Jvinuelapz/5DoF_Robotic_Arm/5DoF_Robotic_Arm.pdf

5DoF Robotic Arm – Group Project

# CT7158 – Robotic Systems

## 5DoF Robotic Arm – Group Project

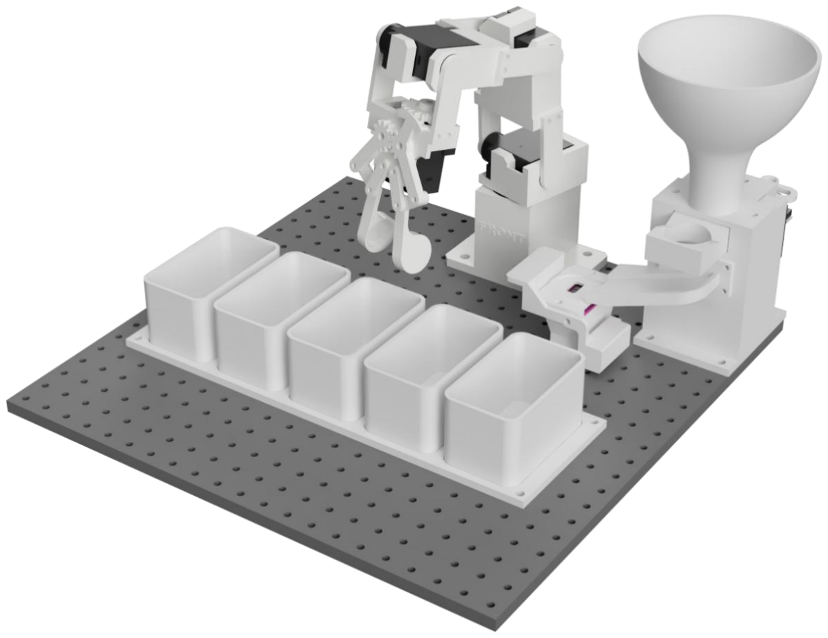
[picture p2: figure]

Authors:
Pawel Toborek (19024794)
Jorge Viñuela (23038621)
Saksham Arora (23022498)
Olayinka Afolabi (23054001)

Supervisors:
Marcio Lacerda
Dion Mariyanayagam
Lynn Crothall

## Table of Contents

## Table of Figures

## List of Tables

## Abstract

This project outlines the design and execution of a 5-degree-of-freedom (5-DoF) robotic arm, including mechanical, electrical, and software components to provide accurate, automated item manipulation. The robotic arm, driven by an ESP32 microcontroller, has servo motors, a color sensor, and an accessible web-based interface for seamless control and operation. The primary functions encompass forward and inverse kinematics, allowing precise movement and placement, alongside a gripper mechanism refined for manipulating tiny items like Skittles.

The arm's capacity to categorize things by color was achieved using sophisticated kinematic algorithms, accurate motion control, and instantaneous data processing. Safety methods were instituted to improve dependability, encompassing joint angle restrictions, motion smoothing, and effective error management. The idea utilized economic materials and 3D-printed elements, guaranteeing accessibility and affordability.

The results indicate the arm's efficacy as a multifunctional platform for educational applications, research, and minor industrial operations. This study highlights the promise of affordable, high-performance robotic systems, establishing a basis for future progress in robotics and automation.

## I. Introduction

## Objective

The objective of this project is to design and develop a 5-degree-of-freedom robotic arm using an ESP32 microcontroller. This project aims to:

1. Build and optimize the robotic arm's structure, including a high-precision gripper.
2. Implement kinematic algorithms to enable accurate control and movement.
3. Develop a user-friendly, web-based interface for intuitive control of the robotic arm.
4. Integrate wireless connectivity to allow remote access and operation.

By achieving these objectives, the project seeks to create a versatile robotic arm suitable for tasks requiring precision and adaptability, while providing a learning platform for robotics and control systems.

## Problem Statement

In various fields such as manufacturing, research, and education, there is a growing need for adaptable and precise robotic systems that can perform complex tasks with minimal human intervention. Traditional robotic arms often lack affordable control solutions with advanced features like wireless connectivity, customizable kinematics, and user-friendly interfaces, which limits their accessibility and usability in smaller-scale or educational contexts [1,2].

This project addresses these issues by developing a low-cost, 5-degree-of-freedom robotic arm that uses an ESP32 microcontroller. The arm will be controlled via an intuitive web-based interface, allowing easy, remote operation and control. Additionally, by optimizing the gripper and implementing kinematics, this project aims to enhance the robotic arm’s precision, making it suitable for applications requiring accurate manipulation and positioning. The project therefore aims to bridge the gap between functionality, affordability, and accessibility in robotic arm systems.

## Relevance of the project

This project holds significant relevance as it combines multiple disciplines—mechanical design, electronics, programming, and kinematics—to create a versatile robotic arm [7]. By using a 5-degree-of-freedom structure, the arm can achieve a high level of manoeuvrability, which is essential for real-world applications like precise object manipulation and sorting. Leveraging the ESP32 microcontroller offers a cost-effective, powerful platform with built-in Wi-Fi, enabling remote control through a user-friendly web interface. This connectivity expands potential uses, from industrial automation to remote education and research applications [8,9,10].

Furthermore, optimizing the gripper design and implementing kinematic algorithms are crucial for achieving accurate and responsive movement. These capabilities enhance the arm’s ability to perform tasks with precision, which is valuable for robotics research and provides students with hands-on experience in solving complex, real-world engineering challenges. This project thus not only serves as an educational tool but also lays the foundation for advancements in robotic control systems and applications.

## Background

Robotic Arm

A robotic arm is a programmable mechanical device that mimics the motion and functionality of a human arm. It typically consists of multiple segments, or links, connected by joints that allow for various degrees of freedom (DoF). Robotic arms are commonly used in industries such as manufacturing, medical technology, and research, where precise, repeatable movements are required. In this project, we aim to design a 5-degree-of-freedom robotic arm capable of performing precise tasks such as sorting and object manipulation. Developing this robotic arm requires careful planning of its kinematic structure, control systems, and end-effector (or gripper) design to ensure both accuracy and reliability [1,3,4,5].

Servo MG90S

The MG90S is a compact, high-torque servo motor commonly used in robotics applications due to its affordability, lightweight design, and performance [13]. It features a metal gear train that ensures durability and precision, making it ideal for applications where high torque and precision control are necessary. Each joint in the robotic arm is driven by an MG90S servo motor, which allows for fine-grained control of the arm’s movement across its various degrees of freedom. These servo motors are critical for achieving the precision required for tasks such as sorting and manipulating objects [6,7,8].

ESP32

The ESP32 is a powerful microcontroller with integrated Wi-Fi and Bluetooth capabilities, making it a popular choice for IoT and robotics applications [12]. Its high processing power, real-time control capabilities, and connectivity options make it ideal for controlling robotic systems like the 5-DoF robotic arm in this project. The ESP32 allows for precise motor control, easy integration of sensors, and wireless communication. This wireless capability is particularly valuable for developing a web-based interface, allowing users to control the robotic arm remotely, enhancing usability and accessibility [9,4,3].

Inverse Kinematics

Inverse kinematics (IK) is a mathematical approach used to calculate the required joint angles of a robotic arm to position its end effector at a specific location and orientation in space. In contrast to forward kinematics, which determines the position of the end effector based on known joint angles, inverse kinematics works backward, starting from the desired endpoint to determine the necessary joint parameters. IK is crucial for applications requiring precision, as it enables the robotic arm to perform complex, accurate movements, allowing it to reach specific points in its workspace. Implementing inverse kinematics in this project will provide the robotic arm with the ability to accurately move and position its gripper, enhancing its usefulness for tasks that require exact positioning, such as sorting or picking objects [1,6,8,5].

## II. Hardware design

The hardware design of the robotic arm incorporates a variety of mechanical and electrical components, ensuring the functionality, stability, and precision required for its operation. This section details the components used in the design, including a Bill of Materials (BOM) and a breakdown of the 3D-printed parts.

## Bill of Materials (BOM)

The table below outlines the components required to assemble the arm, which includes electronic components, servo motors, and various fasteners and bearings. The BOM ensures that all necessary components are accounted for and provides flexibility in sourcing, as it includes detailed specifications for each item.

No | P/N | Link | Price | Items
1 | Torx Screw Set | https://amzn.eu/d/iVCb0gH | £7.99 | Set 760 Pieces
2 | 6x10x3mm Bearings | https://amzn.eu/d/bLbZnPb | £7.99 | 10
3 | 7x22x8mm Bearing | https://amzn.eu/d/cW2G3Cp | £7.09 | 8
4 | TCS34725 | https://amzn.eu/d/2pwwxkY | £4.99 | 1
5 | Servo MG90S | Provided | - | 6
6 | ESP32 Devkit V1 | Provided | - | 1
7 | PCA9685 | Provided | - | 1
8 | SD Card Reader | Provided | - | 1
Table 1. Bill Of Materials

## 3D-Printed parts:

The arm relies heavily on custom-designed 3D-printed parts for its structural integrity. These parts are essential for creating the joints, segments, and gripper mechanisms that facilitate movement and manipulation tasks. Important to remark that the whole robot was redesigned, not only the gripper. The following table provides a detailed breakdown of the required 3D-printed parts.

No | Name | Count
1 | Base | 1
2 | Segment1 Base | 1
3 | Motor Shaft Swing | 3
4 | Bearing Swing | 3
5 | Segment2 Base | 2
6 | Gripper Base | 1
7 | Gripper Main Gear | 1
8 | Gripper Left Gear Arm | 1
9 | Gripper Right Gear Arm | 1
10 | Gripper Left Link | 1
11 | Gripper Right Link | 1
12 | Gripper Left Clamp | 1
13 | Gripper Right Clamp | 1
Table 2. 3D-Printed Parts

Figure 1 shows the 3D-printed components required for the assembly of the robotic arm, each part is positioned for optimal printing, and the preview highlights details such as supports, infill, and walls. The visible parts include bases, joint connectors, motor holders, and the gripper mechanism, all essential for the arm's structural integrity and functionality. The slicing summary indicates a total filament usage of approximately 58.45 grams and an estimated print time of 2 hours.

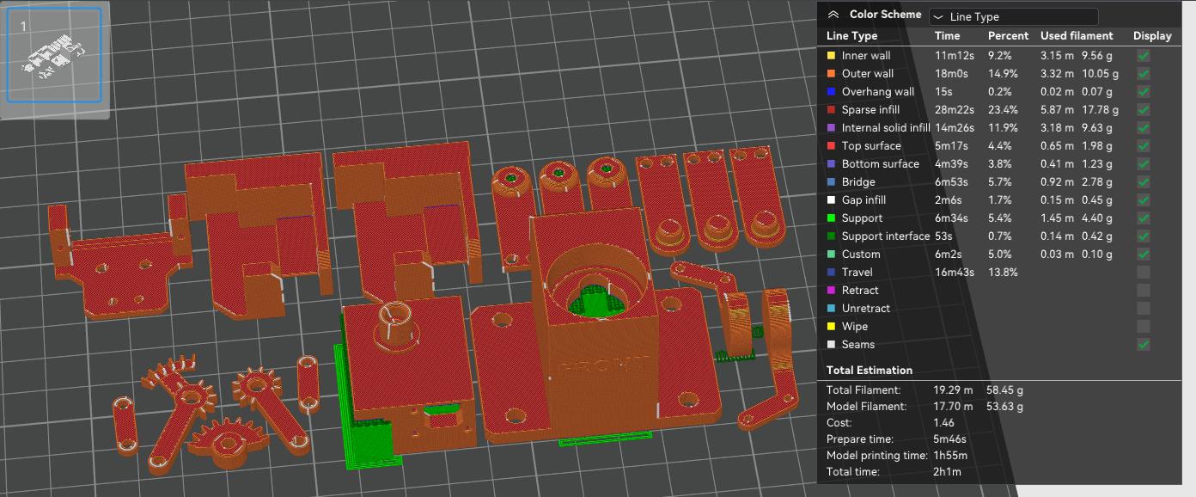
[picture p3: figure]

Figure 1. 3D-Printed Parts Layout and Printing Details

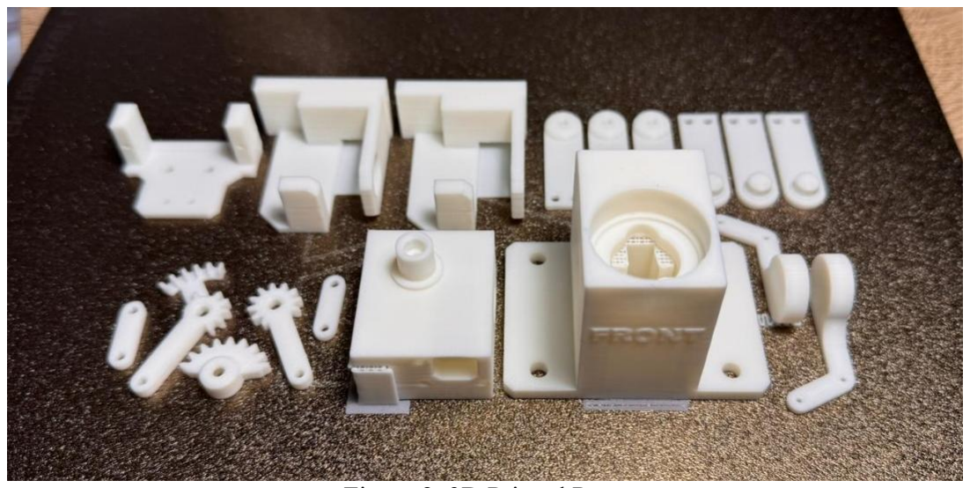
[picture p4: figure]

Figure 2. 3D Printed Parts

## Assembly and Integration

Finally, the integration joins electronic components and 3D-printed parts into a cohesive system. The servos (MG90S) are controlled via the ESP32 microcontroller, which communicates with the PCA9685 servo driver [15]. The structural components are assembled using the screws, spacers, and bearings listed in the BOM, ensuring stability and minimizing wear during operation. The following figure illustrates the complete assembly of all components that form the arm and provides two perspectives of the arm as modelled in Autodesk Fusion 360 [11], showcasing the structural design and arrangement of parts in a 3D environment.

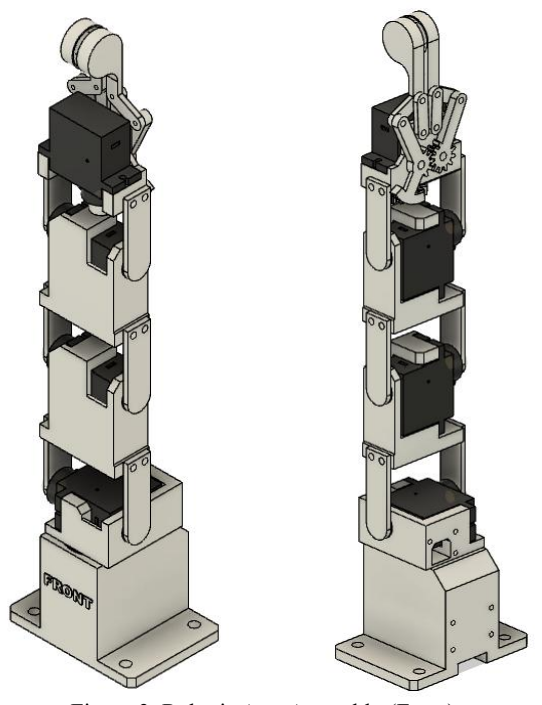
[picture p5: figure]

Figure 3. Robotic Arm Assembly (Front)

Figure 4. Robotic Arm Assembly (Back)

## Wiring Diagram

This section illustrates the electrical connections and integration of the core components, by providing a detailed overview of how the ESP32 microcontroller interfaces with the peripheral modules, including the PCA9685 PWM driver, the TCS34725 colour sensor [14], and the SD card module. Proper wiring ensures efficient communication between components, power delivery, and synchronization, which are critical for the robotic arm's functionality and performance.

Firstly, the ESP32 Devkit V1 is the central microcontroller in the system and is powered by both 5V and 3.3V supplies. The connections include:
- SDA and SCL pins (I2C communication): connected to peripherals such as the PCA9685 PWM driver and the TCS34725 colour sensor.
- MOSI, MISO, and SCK pins (SPI communication): primarily interfacing with the SD card reader module.
- SD_EN pin: used to enable or control the SD card module.

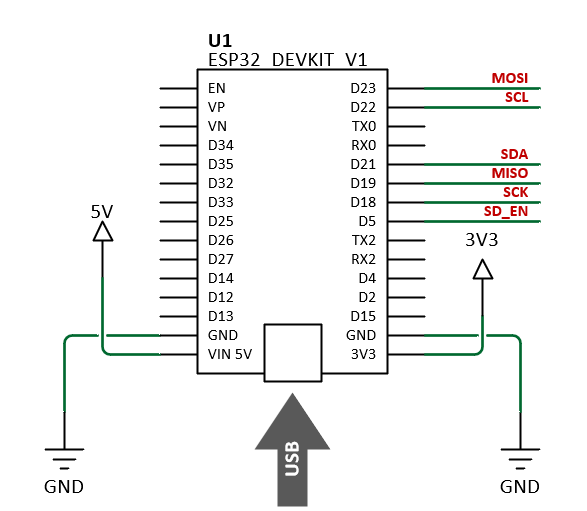
[picture p6: figure]

Figure 5. ESP32 wiring diagram

The PCA9685 servo driver is connected to the ESP32 via the I2C, operates at 3.3V logic levels and drives up to 16 channels of servos.
- Channels CH0 to CH5: used for controlling six servo motors (SERVO_0 to SERVO_5).
- V+ pin: supplies power to the servos, which is independent of the PCA9685’s operating voltage and is provided through an external 5V supply.

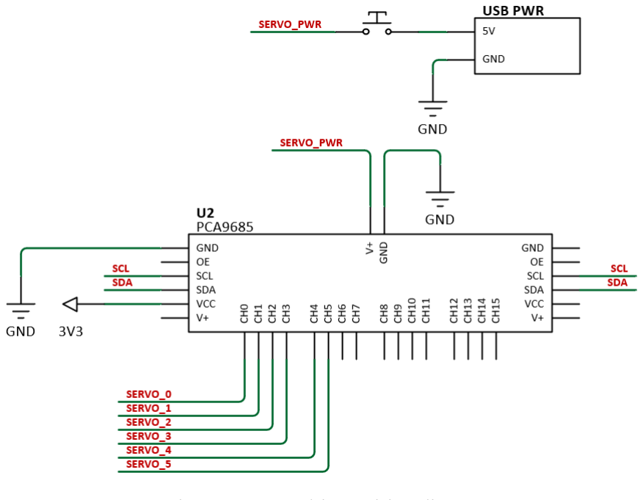
[picture p7: figure]

Figure 6. Servo driver wiring diagram

The TCS34725 colour sensor is also connected to the ESP32 using the I2C interface and operates at 3.3V, with:
- SDA and SCL lines linked to the ESP32 for data communication.
- VIN and GND connected to power and ground, ensuring proper operation of the sensor.

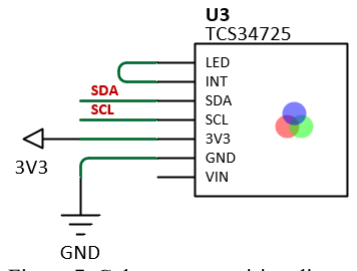
[picture p8: figure]

Figure 7. Colour sensor wiring diagram

Finally, the SD Card module interfaces with the ESP32 using SPI communication:
- MOSI, MISO, SCK, and SD_EN pins: connected to their respective pins on the ESP32.
- VIN and GND connected to power and ground, ensuring proper operation of the sensor, same as in the previous component.

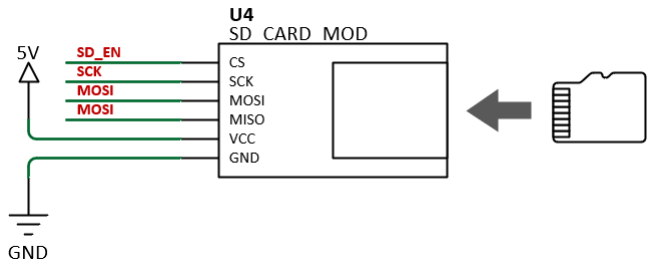
[picture p9: figure]

Figure 8. SD Card wiring diagram

## III. Software Design

## Robotic Arm

This section describes the arm’s different functionalities, showcasing its ability to perform precise and complex movements through advanced algorithms and robust control mechanisms. It is equipped with servo motor control for seamless and accurate joint movements, inverse kinematics for calculating joint angles to achieve specific end-effector positions, and G-code support for programmable, task-specific actions. Additionally, the integration of a colour sensor enables dynamic object detection and sorting, making the arm versatile for a range of applications.

Each functionality is designed to operate cohesively, providing a reliable and efficient system that can adapt to real-world tasks requiring precision and automation. Below, detailed explanations and code snippets highlight the implementation of these functionalities, illustrating how they contribute to the arm’s overall performance.

Arm Definition

The robotic arm is implicitly defined through the combination of servo motor channels managed by the Adafruit_PWMServoDriver and the control logic that governs their movements. The following elements together define the arm:

1. Servo Channels: The arm's joints are represented by up to 16 servo channels on the PCA9685 PWM driver, as instantiated here:

Figure 9. Servo Channels Definition

2. Arm’s links: The arm's structure and movement are governed by inverse kinematics algorithms, as seen in the solveIK3D and solveIK functions. These functions define the geometry of the arm using linkLengths and calculate the required joint angles:

Figure 10. Links Definition

3. Servo Positions: The current and goal positions of the servos are stored in arrays:

Figure 11. Servo Positions Definition

Servo and Speed Control

The robotic arm uses PWM signals to control the angles of the 6 servo motors. The servo positions are mapped from angles in degrees (0–180) to PWM pulse lengths, where each servo is individually addressed, allowing precise control of joint angles.

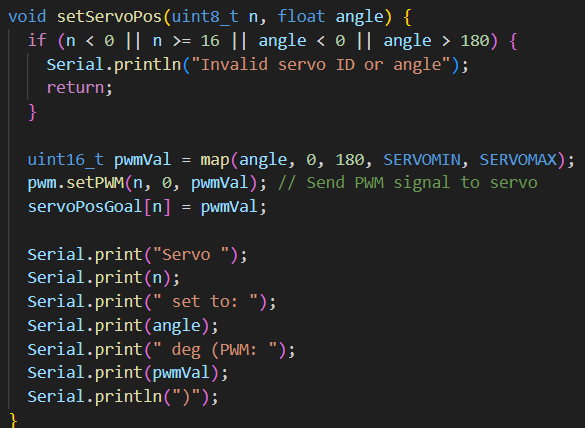
[picture p10: figure]

Figure 12. SetServoPos function

The “setServoPos” function controls the position of a servo motor by converting a given angle into the corresponding PWM signal, which is then sent to the servo using the Adafruit PCA9685 driver. It validates the input to ensure the servo ID and angle are within acceptable ranges and then uses the map function to translate the angle into a PWM pulse length, ensuring the servo moves to the desired position. The resulting PWM value is stored in the “servoPosGoal” array for tracking, and detailed logs are printed for debugging.

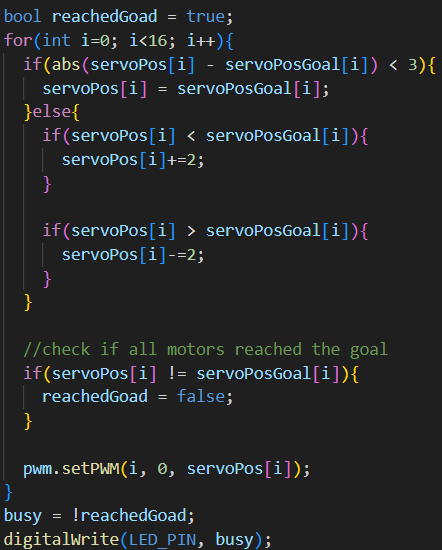
[picture p11: figure]

Figure 13. Smooth servo movement implementation

Once the desired servo position has been obtained, the loop function ensures a smooth servo movement by gradually adjusting each servo's position toward its target, shown in figure 11. If the difference is small, the servo is directly set to the target; otherwise, its position is incrementally increased or decreased to avoid abrupt movements. The program tracks whether all servos have reached their targets using the “reachedGoad” flag, updating the busy state, accordingly, reflected on LED_PIN, which serves as a visual indicator of whether the servos are still in motion or idle.

## Web interface

The website interface was written using HTML and JavaScript. To get the 3D visualization p5js library was used, as it provides easy graphical interface capable of 3D rendering using WEBGL. The website files are served by the ESP32 server inside the SD card with all necessary files. The 3D models are “.stl” files loaded by the JavaScript code.

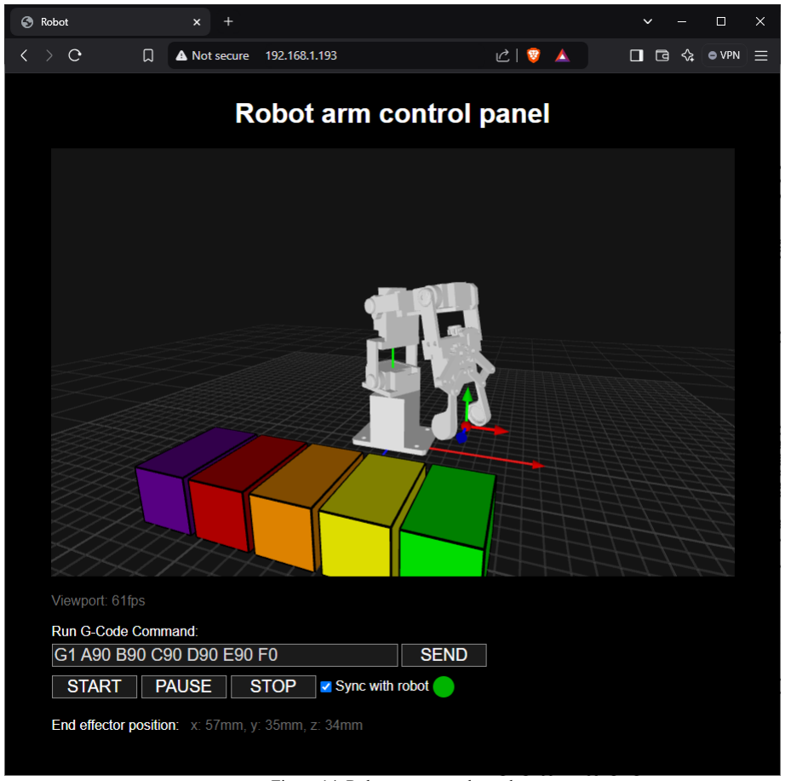
[picture p12: figure]

Figure 14. Robot arm control panel

The web interface includes a text field that allows the user to input G-Code commands to control the robotic arm. Several G-Code commands are supported, including G0, which accepts XYZ coordinates and utilizes inverse kinematics to move the arm to the specified position. Additionally, G1 enables direct control of the motor angles for each joint, offering precise adjustments for the arm's segments. This command also facilitates the operation of other servo channels, making it possible to integrate and manage additional hardware seamlessly.

## Colour Sensor

The integration of the colour sensor adds a vital functionality to the robotic arm, enabling it to detect and classify objects (Skittles) based on their colour. The sensor (TCS34725) reads the red, green, and blue (RGB) components of an object and matches them to predefined categories stored in the “colorList” array. Each entry in the array represents the average RGB values for a specific colour, such as red, green, yellow, or purple.

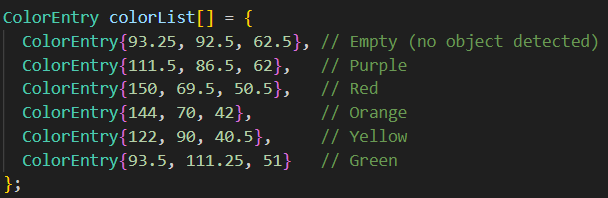
[picture p13: figure]

Figure 15. Colour List Definition

Each colour is represented by its red, green, and blue intensities, allowing the program to match sensor readings to these predefined values. Next, the program calculates the Euclidean distance between the sensor's current RGB readings (r, g, b) and each predefined colour in the list. The colour with the smallest distance is selected as the detected colour, provided the distance is within a defined threshold. This process is described in the following figure.

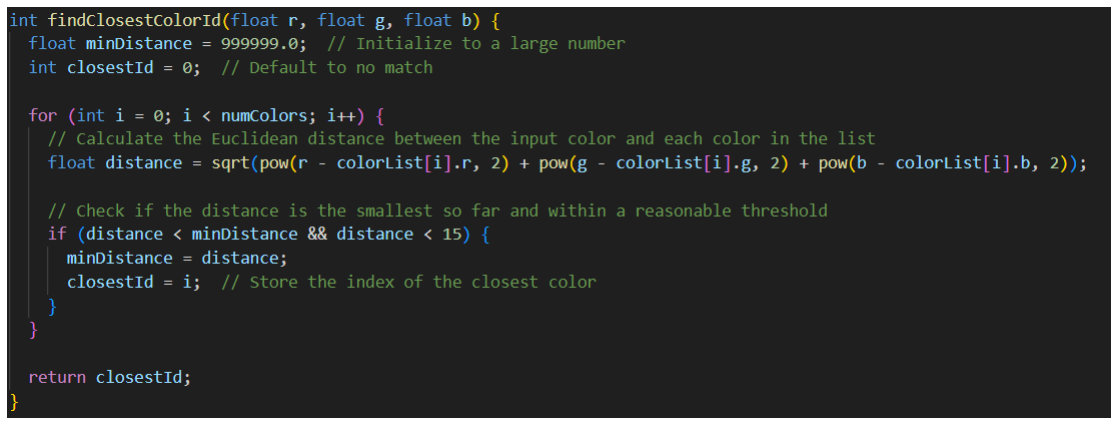
[picture p14: figure]

Figure 16. FindClosestColorId Function

These functions allow the robotic arm to continuously detect colours in real time, ensuring precise and accurate classification for the objects used in this project.

## IV. Inverse kinematics and Safety Mechanism

## Introduction to Inverse Kinematics

Inverse Kinematics (IK) is a fundamental concept in robotic control, enabling the calculation of joint angles to position an end-effector at a specified Cartesian coordinate. IK plays a critical role in improving the functionality of robotic arms by allowing precise, repeatable motions, essential for tasks like assembly, manipulation, and navigation in constrained environments. This section discusses the mathematical underpinnings of IK, the integration of safety mechanisms, and challenges and solutions in implementing these techniques [1][4].

## Mathematical interpretation

The implementation used for the robot described in this report first converts 3D position to 2D position and then solves the IK in 2D space.

The 3D to 2D conversion is done as follows:

baseRot = atan2(Tz

, Tx)
dist = √Tx
2 + Tz

2

dist is the X coordinate in 2D space
Y coordinate is the same as in 3D space (Ty) baseRot is used as the angle for base servo motor.

Forward kinematics:
is the process of calculating the position and orientation of the end-effector based on the joint parameters (such as angles or displacements) of the links in a kinematic chain.

In 2D space this can be done using trigonometric equations:

x = cos(θ1

) ∗ len1 + cos(θ1 + θ2

) ∗ len2 + cos(θ1 + θ2 + θ3

) ∗ len3
y = sin(θ1

) ∗ len1 + sin(θ1 + θ2

) ∗ len2 + sin(θ1 + θ2 + θ3

) ∗ len3

If necessary, the x and y coordinates can be translated by the robot origin position. The forward kinematics algorithm will use forrard kinematics to solve IK with CCD.

2D Inverse Kinematics (CCD):
The Cyclic Coordinate Descent (CCD) algorithm iteratively adjusts each joint of the kinematic chain, starting from the end effector (the last joint) and working backward toward the root joint.

At each iteration, the algorithm modifies one joint's angle to minimize the distance between the end effector and the target.

First, the algorithm checks the distance between the target and current position of the robot’s end-effector. If it is less than the threshold the algorithm returns current motor positions. If the target is not reached, the algorithm calculates the angle to the joint by determining the vector between the joint and the end-effector, as well as the vector between the joint and the target. It then computes the angular difference between these vectors and adjusts the joint's angle accordingly to reduce the distance to the target. This process is repeated iteratively for each joint in the chain until either the target is reached within the specified threshold, or the algorithm reaches its iteration limit.

## Code Implementation

Forward Kinematics

The “calculatePosition” function computes the Cartesian position of a specified point in the robotic arm, such as an intermediate joint or the end-effector. It uses the angles of the joints and the lengths of the links in the arm to iteratively calculate the cumulative position of the arm in 2D space. This function is essential for determining the spatial coordinates of any point along the arm, which is crucial for both visualizing the arm's configuration and performing inverse kinematics calculations.

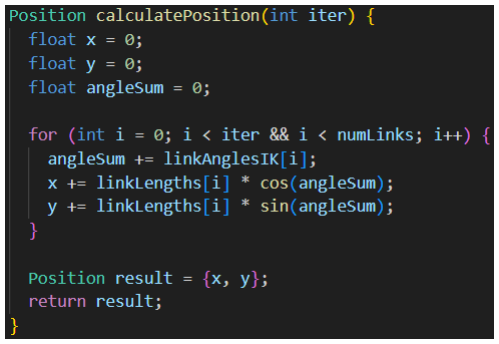
[picture p15: figure]

Figure 17. CalculatePosition function

It iterates through the arm's links up to the specified joint (iter), summing joint angles to determine the arm's cumulative orientation. For each link, it calculates the horizontal and vertical contributions using trigonometric functions scaled by the link lengths, adding these to the running totals. Once all links are processed, the function returns a Position struct with the calculated x and y coordinates, enabling the determination of any joint or end-effector position for motion planning and control. This function is essential for inverse kinematics as it calculates the current position of the end-effector or joints, providing the necessary feedback to iteratively adjust angles and minimize the distance to a target.

Inverse Kinematics

This section explores the implementation of inverse kinematics (IK) for controlling the robotic arm, enabling it to precisely position its end-effector at any target within its workspace. The IK process involves breaking down complex 3D movements into individual joint angles using geometric calculations and algorithms like Cyclic Coordinate Descent (CCD). To achieve this, there are two main functions that we have implemented: solveIK and solveIK3D.

### 1. SolveIK

This function computes the inverse kinematics for a 2D planar arm using the Cyclic Coordinate Descent (CCD) algorithm. Starting from the end-effector, it iteratively adjusts the angles of each joint to minimize the distance between the end-effector and the target position. Then, the CCD algorithm calculates the angle between two vectors: one from the joint to the end-effector and another from the joint to the target and uses this angle to modify the joint’s position and bring the end-effector closer to the target.

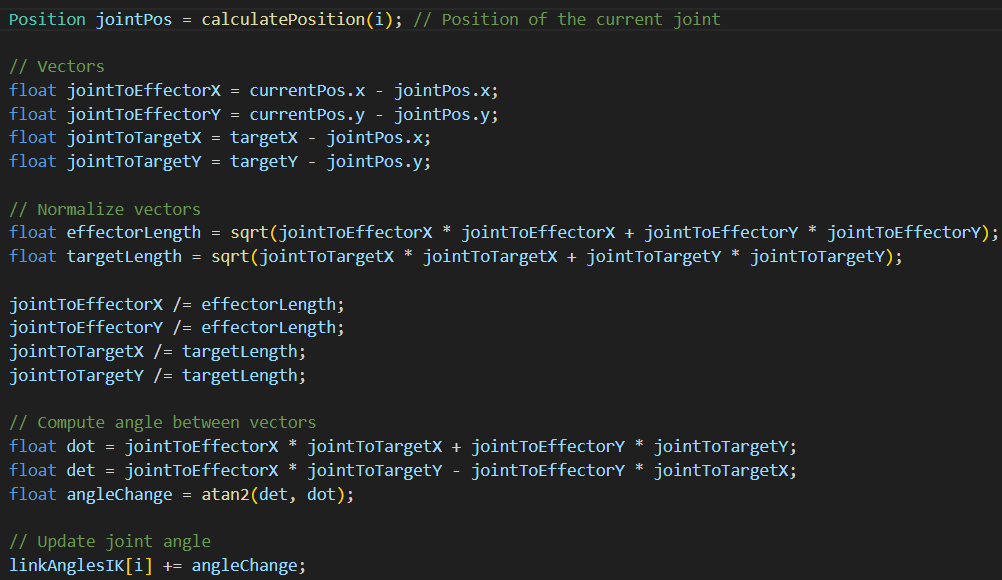
[picture p16: figure]

Figure 18. SolveIK3D function

The process is repeated for each joint in the chain, working backward from the end-effector to the base and continues iterating until the target is reached within a specified tolerance or the iteration limit is exceeded. This function ensures that the arm's joints are positioned correctly to achieve the desired target while respecting physical constraints, such as joint angle limits.

### 2. SolveIK3D

This next function handles the high-level logic for solving inverse kinematics in a 3D space. Firstly, it adjusts the y coordinate to account for the arm's geometry and calculates the base rotation angle to align the arm's base with the target position in the XZ plane, which reduces the target to a planar distance in this plane, effectively converting the 3D problem into a

2D problem. Secondly, the solveIK function previously explained, is called to compute the joint angles in the 2D plane, which are crucial for positioning the end-effector.

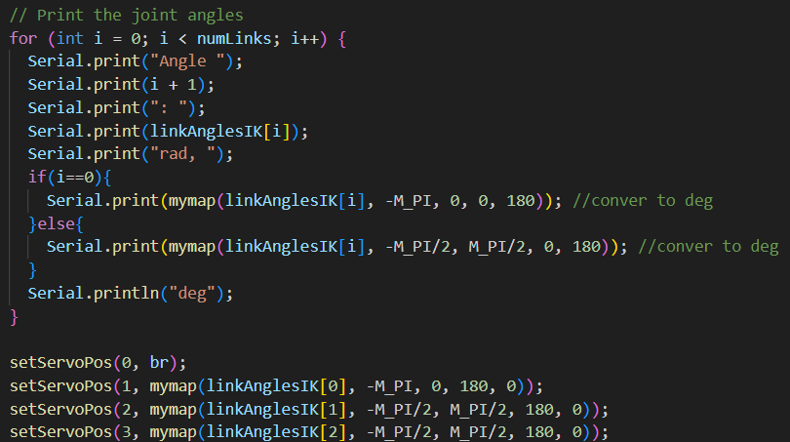
[picture p17: figure]

Figure 19. SolveIK function

After solving the 2D IK, the function maps the calculated base rotation and joint angles to servo-compatible values using the “mymap” function, which scales the input angles from their original range to the range required by the servos. Finally, it sets the positions of the base and joint servos using setServoPos. This function serves as the primary interface for positioning the arm in 3D space.

G-Code Integration

The control system incorporates a G-code interface, enabling the user to program and execute precise sequences of movements and actions through G-code commands, which provide a standardized way to communicate instructions to the arm, offering flexibility and ease of use for complex tasks. To achieve this, the “runGCodeCommand” function was implemented, which parses each command to determine its type (G0 or G1) and extracts the parameters needed for execution. Two G-code commands were added to the project: G0 for inverse kinematics, and G1 for forward kinematics.

### 1. G0 Command

It is used to move the arm to a specific position in the space by specifying XYZ coordinates. Upon receiving a G0 command, the system invokes the solveIK3D function, which calculates the required joint angles and allows the arm to seamlessly reach the target position while respecting its physical constraints. Figure 15 shows the implementation of the “handleG0Command” function.

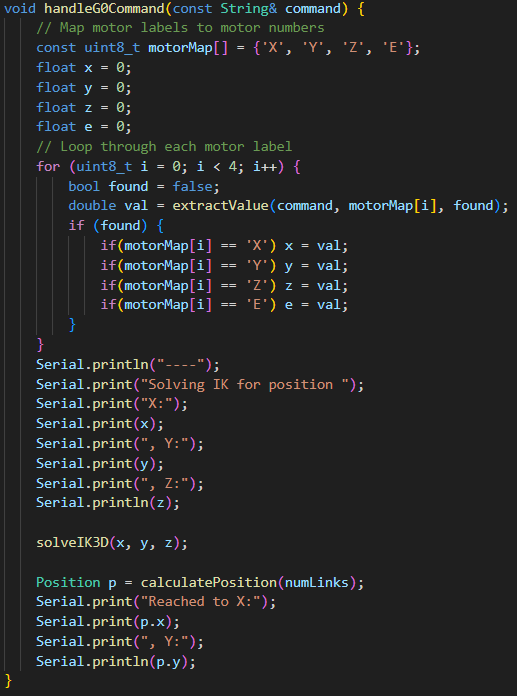
[picture p18: figure]

Figure 20. HandleG0Command function

- Extracting Target Coordinates: It parses the G-code command to extract X, Y, Z, and E values, representing the target 3D position and an optional parameter.
- Solving Inverse Kinematics: It passes the extracted x, y, and z coordinates to the solveIK3D function, which computes the joint angles necessary to move the arm’s end-effector to the specified target position.
- Debugging and Verification: The function prints the extracted coordinates and the arm's final calculated position to ensure the movement is executed as expected.

### 2. G1 Command

It enables direct control of the arm by specifying individual motor angles for each joint (forward kinematics). This command was particularly useful for fine-tuning the movements and creating the loop of sorting the skittles.

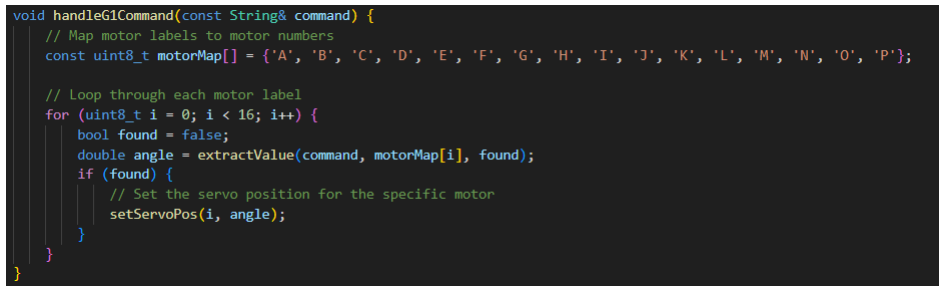
[picture p19: figure]

Figure 21. HandleG1Command function

- Extracting Motor Angles: The function iterates through the motorMap and retrieves the specified angle from the command string. If a valid angle is found, the found flag is set to true, and the angle is stored.
- Setting Servo Positions: If a valid angle is extracted for a motor, the setServoPos function is called, which updates the corresponding servo to the specified position, allowing precise control of each motor based on the command input.

## Viable Safety Features

There are a series of safety features that were implemented throughout the code that contributed to making a secured execution.

### 1. Joint Angle Limits

During the inverse kinematics (IK) calculation in “solveIK” function (Figure 15), the joint angles are clamped to specified limits. This ensures that the arm does not exceed its physical constraints, preventing damage to the servos or structural components.

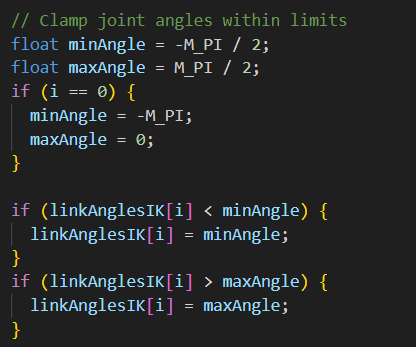
[picture p20: figure]

Figure 22. Angle Limitations Implementation

### 2. IK Iteration Limits

In the solveIK function (Figure 15), the algorithm limits the number of iterations to 100, thus if the solution does not converge within this limit, the process is aborted, and an error message is printed. This prevents the system from entering an infinite loop or performing unnecessary calculations.

Figure 23. IK Iteration Limit Message

### 3. Servo Validation

The setServoPos function (Figure 10) includes checks to ensure that the servo ID and the angle fall within valid ranges. This prevents invalid commands from being sent to the servos, protecting them from operating outside their physical or electrical limits.

### 4. Smooth Motion Control:

The incremental movement logic in the loop function ensures that servos move gradually toward their target positions, which avoids abrupt movements that could strain or damage the arm’s structure or servos. This process was explained in detail in Servo and Speed Control Section.

### 5. Error Detection

The code includes error-handling mechanisms to detect missing or improperly connected components, such as the SD card or colour sensor. If an issue is detected, the program halts or skips operations to prevent further errors.

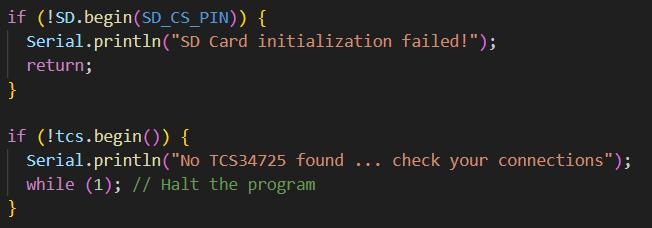
[picture p21: figure]

Figure 24. Disconnected Components Error Messages

## Challenges Faced

Hardware
When designing the hardware, it was noted that the SD card module used required 5V supply. The solution was to connect the VCC to VIN pin on the ESP32 which has direct connection to the USB 5V.

Firmware

Inverse Kinematics posed many challenges due to the limitations of visualising the robot. Also, compilation and upload time is considerable when performing iterative testing and debugging. To ease the development, cycle the IK algorithm was first tested in JS before it was ported to the C++. The algorithm used to solve the IK was finetuned to respect the limitations of the robot, but it has some drawbacks, there are positions that it fails to reach even when it is possible.

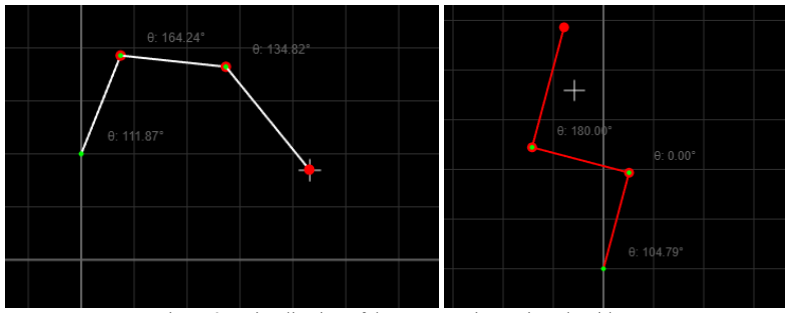
[picture p22: figure]

Figure 25. Visualization of the Inverse Kinematics Algorithm

Implementing Inverse Kinematics in 3D space can get very complex. But the robotic arm described in this report can be treated as 2D robot with rotating base. This is helpful when implementing IK. From the 3D coordinates we can derive the rotation where the robot should face, then we can solve the 2D inverse kinematics, and apply resulted rotations to the robot.

Web Interface

The biggest issue that was faced when developing the web interface was the ESP32 limitation to handle one network request at the same time. Modern servers are fast and capable of serving many clients and requests at the same time. When developing web interface with multiple files for the ESP32 it was crucial to make each request once the previous was finished. Additionally, it was common for the request to fail due to network related issues or since the ESP was not fast enough. To solve this problem, the web interface retries 3 times when the request fails. It also makes sure that there is only one request executed at any given time.

Inverse Kinematics Angles Mapping

During the implementation of the inverse kinematics in the “solveIK3D” function, we encountered a significant challenge with the default map function provided by the Arduino framework. This function is designed to scale input values from one range to another, but it operates exclusively with integers, which posed a problem because the calculations in the inverse kinematics process involve floating-point values, particularly when converting angles in radians to servo-compatible ranges.

To overcome this limitation, we implemented a custom “mymap” function, that unlike the default map function, it supports floating-point arithmetic, ensuring that the scaling of values is precise and free from rounding errors.

Figure 26. Mymap Function

The function was specifically tailored to handle the conversion of joint angles from their calculated ranges to the servo's operational range of [0, 180].

## V. Gripper Improvement

This section focuses on the enhancements made to the robotic arm's gripper, a critical component responsible for handling and manipulating objects. The primary objective of the gripper was to effectively grab and hold Skittles, which guided the development of each design. To explore diverse approaches and optimize performance, each team member designed a unique gripper tailored to this goal. By fostering individual creativity, the team aimed to identify innovative solutions and integrate the most effective features into the final design.

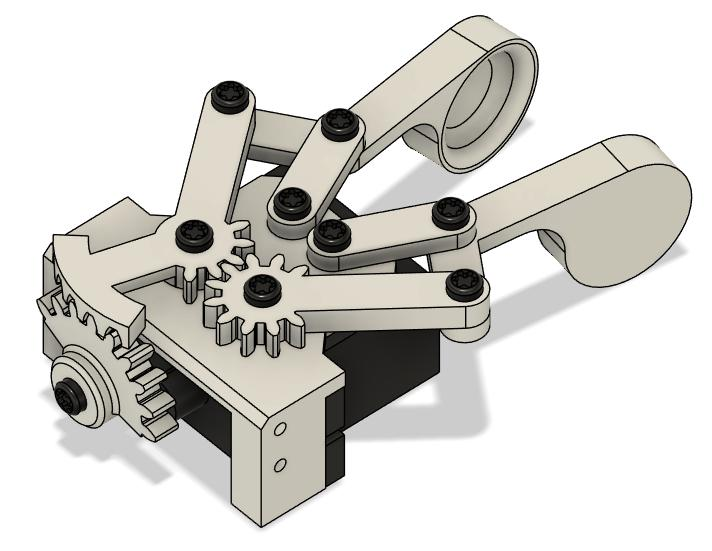
[picture p23: figure]

Figure 27. Gripper 3D Model

This gripper design was inspired by researching different gripper designs. It is complex, but the major benefit is the motor alignment; the motor is rotated 90deg to fit under most of the mechanical components to not protrude to the robot working area. The pinching mechanism was designed to allow for grabbing Skittles candies. After 3D printing, assembling and testing it was successful and determined suitable for the task.

## VI. Testing and Results

## Servo Angle Testing

Firstly, to validate the range of motion of the servo motors used in this project, we conducted a test to determine the maximum angles they could rotate. For this purpose, we designed and fabricated a custom testing device, as shown in the figure, which allowed us to visually measure the angles achieved by the servo and ensure that they aligned with the expected input commands.

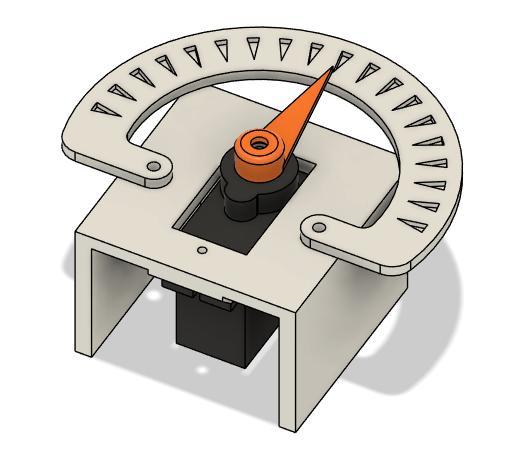
[picture p24: figure]

Figure 28. Servo Angle Testing Device

The device consists of three main components: a base with an integrated angle protractor, a pointer mounted on the servo's rotational axis, and the servo motor itself, secured within the base. The angle protractor was marked with degree measurements every 10 degrees, providing a clear visual reference for the servo’s rotation. The pointer, attached to the servo horn, moves across the protractor scale as the servo rotates, enabling precise measurements of the angles.

To perform the test, we programmed the servo to rotate to specific angles ranging from 0° to 180°, using the setServoPos function. As the servo moved, we recorded the pointer's position on the protractor to verify that the servo accurately reached the commanded angles. This process allowed us to confirm the operational range of the servos and detect any deviations or mechanical limitations that could impact the arm's performance.

## Inverse and Forward Kinematics Testing

Secondly, to validate the consistency and accuracy of the robotic arm's inverse kinematics and forward kinematics calculations, we conducted a test to compare the input and output 3D coordinates (XYZ). The objective of this test was to ensure that the IK algorithms correctly calculated joint angles to reach a specified position and that the FK algorithms accurately reconstruct the resulting XYZ position based on the arm's final joint angles.

The testing procedure began by providing a set of target coordinates in 3D space through the robotic arm's API, which was tested using Postman. These coordinates were passed to the IK system, which calculated the joint angles necessary to position the arm's end-effector at the specified location. The calculated joint angles were then sent to the servos, moving the arm to the corresponding position. Once the robotic arm reached the target position, the FK system was used to calculate the actual XYZ coordinates of the end-effector based on the joint angles of the servos.

These reconstructed coordinates were compared to the original target XYZ coordinates to evaluate the accuracy of both the IK and FK systems. The process was repeated for multiple target positions to ensure consistency and reliability across the arm's workspace. This iterative testing process was critical for refining the arm's kinematic calculations and ensuring reliable operation for tasks requiring precise positioning.

## Inverse Kinematics Demonstration Process

Thirdly and finally, to showcase the successful implementation of IK in the robotic arm, we developed a process that allows the user to send target coordinates directly to the robot via the web interface. This process used the G0 G-code command, which accepts XYZ coordinates and moves the robotic arm to the specified position in 3D space.

Figure 29. Example G0 Command for IK Demonstration

When a G0 command with target coordinates is sent through the web interface, as shown in the figure, the robotic arm begins by parsing the command using the “handleG0Command” function. This function extracts the XYZ coordinates and passes them to the “solveIK3D” function, which calculates the joint angles required to position the arm’s end-effector at the target location, the base rotation is determined, and finally the target is converted into a 2D plane for further calculations using the “solveIK function”. Once the angles are computed, the “setServoPos” function is used to map the calculated angles to servo positions, ensuring precise movement of the arm’s joints.

The robotic arm then moves to the specified position in real-time, allowing the user to visually confirm the accuracy of the IK implementation. This process not only validates the IK functionality but also provides a user-friendly way to control the arm for various applications, demonstrating its flexibility and responsiveness.

## Sorting Process and Results

This whole project was designed with the objective of sorting Skittles based on their colour, utilizing a combination of custom hardware and software functions. The final setup consists of four key components: the robotic arm, the Skittle dropper, the base platform, the sorting cases, the electronic case and the robotic arm.

### 1. Skittles Dropper

It is composed of three main elements: a hopper, a sliding ramp, and a servo-controlled gate. The hopper holds the Skittles, allowing them to funnel down onto the ramp, the slide guides the Skittles toward the colour sensor station and the servo motor controls the gate, releasing one Skittle at a time to ensure accurate detection and processing.

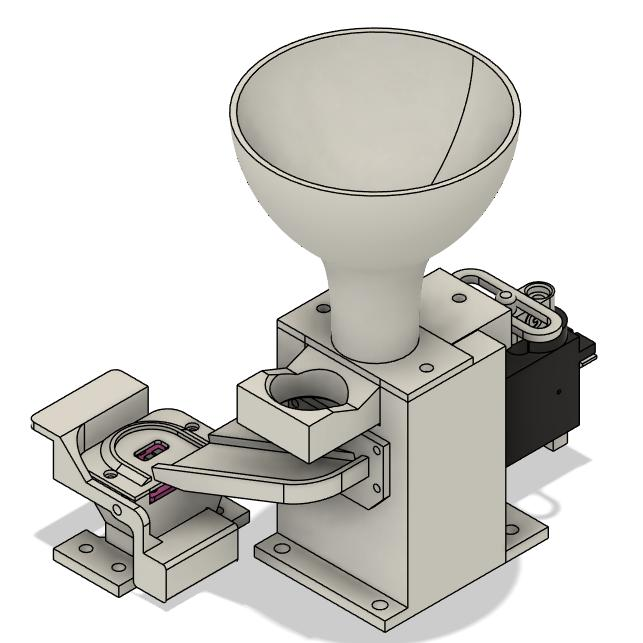
[picture p25: figure]

Figure 30. Skittles Dropper

### 2. Sorting Cases

These containers are designed to organize Skittles by colour after sorting, positioned at the base of the robotic arm's workspace, they provide a clear and accessible location for the robot to deposit them, ensuring easy separation and storage for each colour category.

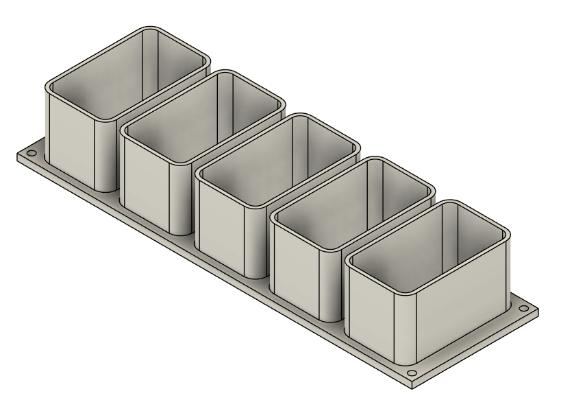
[picture p26: figure]

Figure 31. Sorting Cases

### 3. Base Platform

It serves as a stable foundation for the entire system, including the robotic arm, Skittles dropper, and sorting cases. It is perforated to allow easy attachment and alignment of all components, ensuring a secure and modular design.

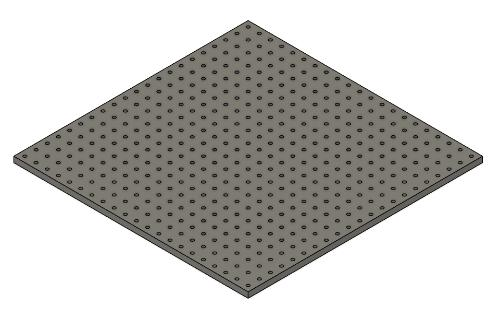
[picture p27: figure]

Figure 32. Base Platform

### 4. Electronic Case

The ESP32 microcontroller, PCA9685 servo driver, and SD card module are housed within the case, which is designed to neatly organize the electronic components. Separate power supplies are provided for the servo driver and ESP32 to ensure stable operation under heavy loads. Ventilation and cable management are incorporated into the enclosure to protect the electronics and maintain efficient wiring.

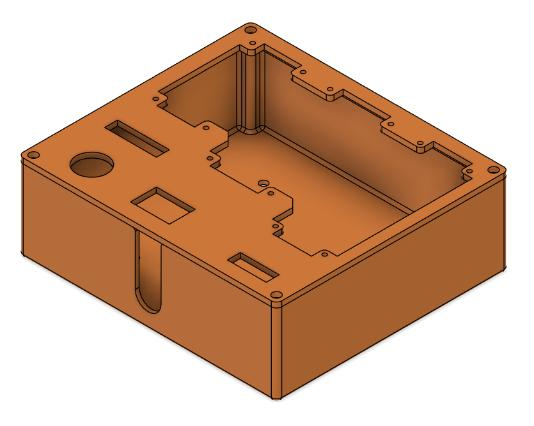
[picture p28: figure]

Figure 33. Electronic Case

### 5. Robotic Arm

The robotic arm is a multi-jointed assembly capable of precise movement to pick and place Skittles; features six servo motors controlled by the ESP32 and servo driver, enabling dynamic motion. The arm is equipped with a custom gripper for securely handling the objects during sorting tasks and its range of motion allows it to interact seamlessly with both the colour sensor station and the sorting cases.

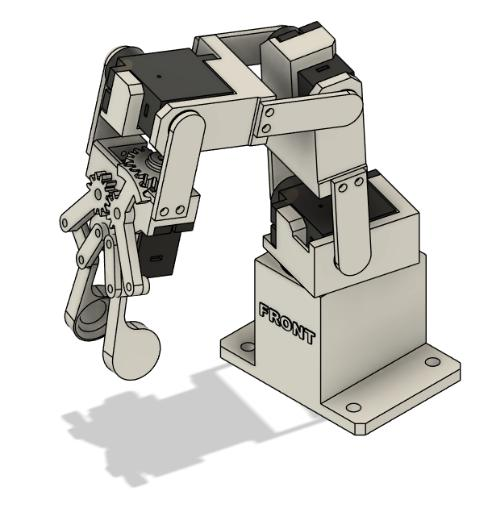
[picture p29: figure]

Figure 34. Robotic Arm

Except for the servo motors and screws used for assembly, all structural components of the system are entirely 3D-printed. This approach allowed for rapid prototyping, customization, and cost efficiency while maintaining functionality and durability. All these elements join to form the final setup, as the following figure shows.

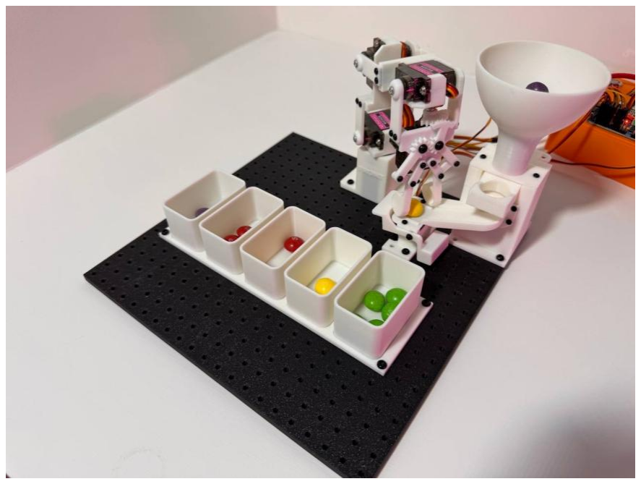
[picture p30: figure]

Figure 36. | Final Setup
of the Robotic | System

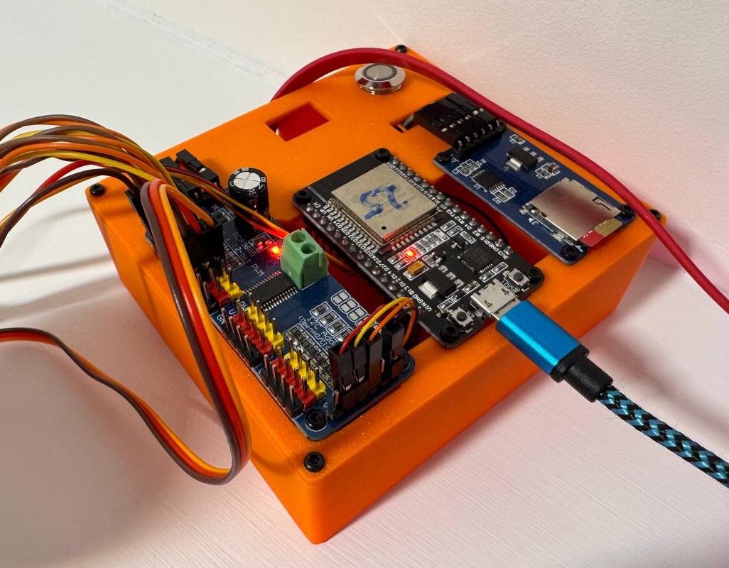
[picture p31: figure]

Figure 37. Circuit Box

The process begins with a Skittle sliding down the ramp from the dropper into the colour sensor stand, where its RGB values are measured using the colour sensor. The function “tcs.getRGB” retrieves the red, green, and blue components of the Skittle’s colour, and the “findClosestColorId” function compares these values to a predefined list of colours in the system (colorList), named in previous sections. Once the colour is identified, the robotic arm is instructed to act.

Figure 35 Final Setup of the Robotic System

The robotic arm, controlled through forward kinematics, positions itself at the sensor stand to pick up the Skittle and, using the “setServoPos” function, the gripper opens to prepare for grabbing the object. After closing the gripper to secure the object, the arm moves to the corresponding sorting case. The movement is coordinated through precise servo angle adjustments, which are pre-calculated for each sorting position. Upon reaching the target case, the gripper opens to release the Skittle into the appropriate container. The arm then returns to its starting position above the sensor stand to wait for the next object. This loop is repeated continuously, allowing the system to sort Skittles indefinitely until there are none left.

This process effectively demonstrates the robotic arm's ability to perform a complete pick-and-place task while integrating colour sorting functionality. By combining precise motion control, accurate colour detection, and seamless coordination between components, the system achieves the goal of sorting Skittles into their respective containers. The process can be observed in a video accessible through the following link: https://youtu.be/oouUzXQNhF4

## VII. Conclusion

The 5-DoF robotic arm project successfully fulfilled its key objectives:

1. Structural Design and Optimization: The robotic arm’s structure, including a high-precision gripper, was effectively built and optimized using 3D-printed components and economical materials, able to pick and place an object.
2. Implementation of Kinematic Algorithms: Advanced forward and inverse kinematics were implemented, enabling precise motion control and positioning of the robotic arm.
3. Development of a Web-Based Interface: A user-friendly and interactive web interface was developed, providing seamless remote control and operation of the robotic system.
4. Integration of Wireless Connectivity: Wireless communication through the ESP32 microcontroller facilitated intuitive control and enhanced system accessibility.

These achievements underscore the project’s success in creating a versatile robotic arm suitable for precision-driven tasks like colour sorting. Safety mechanisms, robust error-handling features, and modular design further ensured the system’s reliability and adaptability.

Future improvements could include implementing object detection to avoid collisions within the workspace and designing a more refined and protective case for electronic components. These enhancements would further broaden the system's applications and usability, paving the way for industrial and research advancements in affordable robotics.

## References

[1]. VD Cong, "Design and Development of a Cost efficiency Robot Arm with a PLC-based
Robot | Controller," | FME | Transactions, | 2024. | [Online]. | Available:
https://www.mas.bg.ac.rs/_media/istrazivanje/fme/vol52/2/6_v._d._cong.pdf.

[2]. J. Chang, "WPI Robotic Mascot," Worcester Polytechnic Institute, 2019. [Online]. Available: https://digital.wpi.edu/downloads/fn107154k.

[3]. L. Loughlin, "TRASHBOT: Mobile Garbage Collecting Robot," Worcester Polytechnic Institute, 2024. [Online]. Available: https://digital.wpi.edu/downloads/6h440x69q.

[4]. LFC Ccari, WA Aguilar, ES Espinoza, "Robust Finite-Time Adaptive Nonlinear Control System for an EOD Robotic Manipulator: Design, Implementation and Experimental Validation," IEEE Transactions on Control Systems Technology, 2024. [Online]. Available: https://ieeexplore.ieee.org/abstract/document/10587221/.

[5]. WA Salah, AA Sneineh, "Smartphone Sensor-based Development and Implementation of a Remotely Controlled Robot Arm," Journal of Robotics and Control, 2024. [Online]. Available: https://journal.umy.ac.id/index.php/jrc/article/view/21987.

[6]. M. Desai, H. Mewada, H. Chhajed, "Gesture Dependable Robotics ARM Movement: ROS and Machine Learning Perspective," in Proceedings of the 9th South-East European
Conference | on | Intelligent | Systems, | 2024. | [Online]. | Available:
https://ieeexplore.ieee.org/abstract/document/10734617/.

[7]. T. Saleh, "Three DoF articulated robotic manipulator for teaching and learning," IET
Conference | Proceedings, | 2022. | [Online]. | Available: | https://digital-
library.theiet.org/content/conferences/10.1049/icp.2022.2264. (https://digital-library.theiet.org/content/conferences/10.1049/icp.2022.2264)

[8]. UU Deshpande, "Unmanned Drug Delivery Vehicle for COVID-19 Wards in Hospitals,"
Journal | of | Computer | Systems | Research, | 2021. | [Online]. | Available:
https://journals.bilpubgroup.com/index.php/jcsr/article/view/3489.

[9]. G. Kulkarni, A. Mahindrakar, "Kinematics And Structural Analysis Of 6 DOF Robotic
Arm," | NeuroQuantology, | 2022. | [Online]. | Available:
https://search.proquest.com/openview/cad9751f7ef017f06e3065be65f5afcd.

[10]. T. Wang, "Supporting the Design and Authoring of Pervasive Smart Environments,"
Purdue | University, | 2022. | [Online]. | Available:
https://hammer.purdue.edu/articles/thesis/Supporting_the_Design_and_Authoring_of_Pervasive_Smart_Environments/19349831/1/files/34401371.pdf. (https://hammer.purdue.edu/articles/thesis/Supporting_the_Design_and_Authoring_of_Pervasive_Smart_Environments/19349831/1/files/34401371.pdf)

[11]. Autodesk, Inc., "Fusion 360," Autodesk, Inc., San Rafael, CA, USA. [Online]. Available: https://www.autodesk.com/products/fusion-360

[12]. Espressif Systems, | "ESP32 | Series | Datasheet," | 2024. | [Online]. Available:
https://www.espressif.com/sites/default/files/documentation/esp32_datasheet_en.pdf.

[13]. Components101, "MG90S Micro Servo Motor Datasheet, Wiring Diagram & Features," n.d. [Online]. Available: https://components101.com/motors/mg90s-metal-gear-servo-motor. (https://components101.com/motors/mg90s-metal-gear-servo-motor)

[14]. ams AG, "TCS3472 Datasheet: Color Light-to-Digital Converter with IR Filter," 2016. [Online]. Available: https://cdn-shop.adafruit.com/datasheets/TCS34725.pdf.

[15]. NXP Semiconductors, "PCA9685 16-Channel, 12-bit PWM Fm+ I²C-Bus LED
Controller | Datasheet," | Apr. | 2015. | [Online]. | Available:
https://www.nxp.com/docs/en/data-sheet/PCA9685.pdf.

## Appendices

## Main Code

#include <WiFi.h>

#include <FS.h>

#include <SD.h>

#include <WebServer.h>

#include <ArduinoJson.h>

#include <Wire.h>

#include <Adafruit_PWMServoDriver.h>

#include "Adafruit_TCS34725.h"

#include <math.h>

#define LED_PIN 2 // Define the GPIO for the LED

#define SD_CS_PIN 5 // SD card CS pin (adjust according to your wiring)

struct ColorEntry {
float r, g, b;
};

struct Position {
float x;
float y;
};

// Link lengths (IK)
float linkLengths[] = {50.0, 50.0, 75.0}; float linkAnglesIK[] = {-1.57, 0, 1.57}; const int numLinks = 3;
const float tolerance = 0.5;

ColorEntry colorList[] = {
ColorEntry{93.25, 92.5, 62.5}, // Empty (no object detected)
ColorEntry{111.5, 86.5, 62}, | // Purple
ColorEntry{150, 69.5, 50.5}, | // Red
ColorEntry{144, 70, 42}, | // Orange
ColorEntry{122, 90, 40.5}, | // Yellow
ColorEntry{93.5, 111.25, 51} | // Green
};

int numColors = 6;

// WiFi credentials
const char* ssid = "WIFI SSID"; const char* password = "PASSWORD";

// Create a web server on port 80
WebServer server(80);

#define SERVOMIN 80 // This is the 'minimum' pulse length count (out of 4096)

#define SERVOMAX 460 // This is the 'maximum' pulse length count (out of 4096)

#define SERVOMID 270

#define USMIN 600 // This is the rounded 'minimum' microsecond length based on the minimum pulse of 150

#define USMAX 2400 // This is the rounded 'maximum' microsecond length based on the maximum pulse of 600

#define SERVO_FREQ 50 // Analog servos run at ~50 Hz updates

Adafruit_PWMServoDriver pwm = Adafruit_PWMServoDriver(0x40);
Adafruit_TCS34725 tcs = Adafruit_TCS34725(TCS34725_INTEGRATIONTIME_2_4MS, TCS34725_GAIN_4X);

int servoPos[16];
int servoPosGoal[16];
bool busy = false;

long timeToUpdateServo = 0;

String inputString = ""; // A string to hold incoming data
bool stringComplete = false; // Whether the string is ready to be processed

float sns_red, sns_green, sns_blue;
int color_id = -1;

//G-code
int gCodePointer = 0;
long blockExecutionUntil = 0;
bool runGCodeExecution = false; //runGCodeProgram int ifStack = 0;

String program[] = {
":START",
"G1 A90 B90 C60 D20 E65 F0", ":DISPENSE",
"G1 A150 B90 C10 D5 E65",
"G1 F180",
"WAIT 500",
"G1 F0",
"WAIT 500",
":GET_COLOR",
"COLOR",
"IF COLOR == 0",
"WAIT 2000",
"JMP DISPENSE",
"END",
":GRAB",
"G1 E90",
"WAIT 500",
"G1 A150 B100 C30 D5",
"// DROP AT PURPLE BOX",
"IF COLOR == 1",
"G1 A60 B70 C30 D50",
"G1 E70",
"END",
"// DROP AT RED BOX",
"IF COLOR == 2",
"G1 A75 B80 C30 D30",
"G1 E70",
"END",
"// DROP AT ORANGE BOX",
"IF COLOR == 3",
"G1 A90 B80 C30 D30",
"G1 E70",
"END",
"// DROP AT YELLOW BOX",
"IF COLOR == 4",
"G1 A110 B80 C30 D30",
"G1 E70",
"END",
"// DROP AT GREEN BOX",
"IF COLOR == 5",
"G1 A125 B55 C60 D20",
"G1 E70",
"END",
"G1 E70",
"WAIT 1000",
"G1 A90 B90 C60 D20 E70",
"WAIT 250",
"JMP START"
};

void logRequest() {
String clientIP = server.client().remoteIP().toString(); // Get client IP
String method = (server.method() == HTTP_GET) ? "GET" : "POST"; // Determine request method String path = server.uri(); // Requested path

// Log client IP, method, and requested path
Serial.print("[");
Serial.print(millis());
Serial.print("] ");
Serial.print("Client ");
Serial.print(clientIP);
Serial.print(" requested "); Serial.print(method);
Serial.print(" ");
Serial.println(path);
}

void handlePreflight() {
// Send CORS headers for preflight response handleCORS();
server.send(204); // No Content response for preflight }

void handleCORS() {
server.sendHeader("Access-Control-Allow-Origin", "*"); server.sendHeader("Access-Control-Allow-Methods", "GET, POST, OPTIONS"); server.sendHeader("Access-Control-Allow-Headers", "Content-Type");
}

// Function to serve static files from SD card
void handleFileRequest() {
logRequest();
if (server.method() == HTTP_OPTIONS) { handlePreflight();
return;
}

String path = server.uri();
if (path.endsWith("/")) {
path += "index.html"; // Serve index.html if root directory is accessed }

String contentType = getContentType(path);

// Try to open the requested file
if (SD.exists(path)) {
File file = SD.open(path); Serial.print("File ");
Serial.print(path);
Serial.println(" found!"); server.streamFile(file, contentType); file.close();
} else {
// If file is not found, return 404 server.send(404, "text/plain", "File Not Found"); }
}

// Helper function to determine content type
String getContentType(String filename) {
if (filename.endsWith(".html")) return "text/html";
if (filename.endsWith(".css")) return "text/css";
if (filename.endsWith(".js")) return "application/javascript"; if (filename.endsWith(".png")) return "image/png";
if (filename.endsWith(".jpg")) return "image/jpeg";
if (filename.endsWith(".gif")) return "image/gif";
if (filename.endsWith(".json")) return "application/json"; return "text/plain";
}

// API handler for toggling LED
void handleToggleLED() {
logRequest();
static bool ledState = false;
ledState = !ledState;
digitalWrite(LED_PIN, ledState ? HIGH : LOW);
server.send(200, "application/json", "{\"status\":\"LED toggled\"}"); }

// API handler for returning millis()
void handleGetMillis() {
logRequest();
unsigned long uptime = millis();
String jsonResponse = "{\"millis\":" + String(uptime) + "}"; server.send(200, "application/json", jsonResponse);
}

// API handler for RGB sensor void handleGetRGB() {

logRequest();
String jsonResponse = "{\"R\":" + String(sns_red) + ",\"G\":" + String(sns_green) + ",\"B\":" + String(sns_blue) + "}";
server.send(200, "application/json", jsonResponse);
}

// API handler for setting multiple servo positions via POST request void setServoPosition() {
logRequest();
handleCORS();

// Check if request body contains JSON if (server.hasArg("plain")) {
// Parse the JSON
StaticJsonDocument<400> doc;
DeserializationError error = deserializeJson(doc, server.arg("plain"));

// Handle JSON parsing error
if (error) {
server.send(400, "application/json", "{\"status\":\"Invalid JSON\"}"); return;
}

// Create a response object
DynamicJsonDocument response(200);

// Loop over each key-value pair in the JSON object
for (JsonPair kv : doc.as<JsonObject>()) {
String key = kv.key().c_str();

// Check if key is in the format "servoX" where X is an integer
if (key.startsWith("servo") && key.length() > 5) {
int servoID = key.substring(5).toInt(); // Extract servo ID number int position = kv.value().as<int>(); // Get servo position

// Ensure the position is within valid bounds (0-180)
if (position >= 0 && position <= 180) {
setServoPos(servoID, position);
response[key] = "Updated to " + String(position); } else {
response[key] = "Position out of range";
}
} else {
response[key] = "Invalid key format";
}
}

// Send response with the status for each servo updated String jsonResponse;
serializeJson(response, jsonResponse); server.send(200, "application/json", jsonResponse);
} else {
// Respond with an error if no body is provided
server.send(400, "application/json", "{\"status\":\"No JSON body found\"}"); }
}

void getServoPosition() {
//logRequest();
handleCORS();

// Create a JSON document to store the response
DynamicJsonDocument response(400); // Adjust size if you have more than 16 servos

// Map raw PWM values to angles (0-180 degrees) for each servo
for (int i = 0; i < 16; i++) { // Assuming 16 servos
int angle = map(servoPosGoal[i], SERVOMIN, SERVOMAX, 0, 180); // Map to 0-180 String servoKey = "servo" + String(i); // Create key in the format "servoX" response[servoKey] = angle;
}

// Serialize the response to JSON
String jsonResponse;

serializeJson(response, jsonResponse);

// Send the JSON response
server.send(200, "application/json", jsonResponse); }

// API handler for setting multiple servo positions via POST request void setServoPWM() {
logRequest();

if (server.method() == HTTP_OPTIONS) {
handleCORS();
server.send(204); // No Content return;
}

// Check if request body contains JSON if (server.hasArg("plain")) {
// Parse the JSON
StaticJsonDocument<400> doc;
DeserializationError error = deserializeJson(doc, server.arg("plain"));

// Handle JSON parsing error
if (error) {
server.send(400, "application/json", "{\"status\":\"Invalid JSON\"}"); return;
}

// Create a response object
DynamicJsonDocument response(200);

// Loop over each key-value pair in the JSON object
for (JsonPair kv : doc.as<JsonObject>()) {
String key = kv.key().c_str();

// Check if key is in the format "servoX" where X is an integer
if (key.startsWith("servo") && key.length() > 5) {
int servoID = key.substring(5).toInt(); // Extract servo ID number int position = kv.value().as<int>(); // Get servo position

// Ensure the position is within valid bounds (0-180)
if (position >= 0 && position <= 4096) {
//pwm.setPWM(i, 0, position);
servoPosGoal[servoID] = position;
//servoPos[i] = position;

//setServoPos(servoID, position);
response[key] = "Updated to " + String(position); } else {
response[key] = "Position out of range";
}
} else {
response[key] = "Invalid key format";
}
}

// Send response with the status for each servo updated String jsonResponse;
serializeJson(response, jsonResponse); server.send(200, "application/json", jsonResponse);
} else {
// Respond with an error if no body is provided
server.send(400, "application/json", "{\"status\":\"No JSON body found\"}"); }
}

// API handler for running a GCode command
void runGCodeCommandHandler() { logRequest();
handleCORS();

// Check if request body contains JSON if (server.hasArg("plain")) {

// Parse the JSON
StaticJsonDocument<200> doc;
DeserializationError error = deserializeJson(doc, server.arg("plain"));

// Handle JSON parsing error
if (error) {
server.send(400, "application/json", "{\"status\":\"Invalid JSON\"}"); return;
}

// Extract the "command" field from the JSON
if (doc.containsKey("command")) {
String command = doc["command"].as<String>();

// Run the GCode command
runGCodeCommand(command, false);

// Respond with success
String response = "{\"status\":\"Command executed successfully\", \"command\":\"" + command + "\"}";
server.send(200, "application/json", response);
} else {
// Respond with error if "command" key is missing
server.send(400, "application/json", "{\"status\":\"Missing 'command' field\"}"); }
} else {
// Respond with an error if no body is provided
server.send(400, "application/json", "{\"status\":\"No JSON body found\"}"); }
}

// Validate and Update setServoPos() function
void setServoPos(uint8_t n, float angle) {
// Validate if the servo ID is within range (0-15) if (n < 0 || n >= 16) {
Serial.println("Invalid servo ID");
return;
}

if(angle < 0 || angle > 180){ Serial.println("Invalid servo angle"); return;
}

// Map the angle to the appropriate PWM value
uint16_t pwmVal = map(angle, 0, 180, SERVOMIN, SERVOMAX); //pwm.setPWM(n, 0, pwmVal); // Corrected to send PWM on channel 'n' servoPosGoal[n] = pwmVal;
if(n == 5){
// servoPos[n] = pwmVal;
if(pwmVal > 90){
pwmVal = 90;
}
}

Serial.print("Servo ");
Serial.print(n);
Serial.print(" set to: "); Serial.print(angle);
Serial.print("deg (");
Serial.print(pwmVal);
Serial.println(")");

}

void setServoPulse(uint8_t n, double pulse){
double pulselength;
pulselength = 1000000; | // 1,000,000 us per second
pulselength /= SERVO_FREQ; | // Analog servos run at ~60 Hz updates
Serial.print(pulselength); Serial.println(" us per period"); pulselength /= 4096; // 12 bits of resolution Serial.print(pulselength); Serial.println(" us per bit");

pulse *= 1000000; // convert input seconds to us pulse /= pulselength;
Serial.println(pulse);
pwm.setPWM(n, 0, pulse);
}

void setup() {
Serial.begin(115200);
Serial.println("Serial begin");

// Initialize LED pin
pinMode(LED_PIN, OUTPUT);
digitalWrite(LED_PIN, LOW); // Start with LED off

Serial.println("TCS34725 Init");
if (tcs.begin()) {
Serial.println("Found sensor");
} else {
Serial.println("No TCS34725 found ... check your connections"); while (1); // halt!
}

tcs.setInterrupt(true); //turn off LED

Wire.begin();
pwm.begin();
pwm.setOscillatorFrequency(27000000); pwm.setPWMFreq(50);
Wire.setClock(100000);

for(int i=0; i<16; i++){
pwm.setPWM(i, 0, SERVOMID); servoPosGoal[i] = SERVOMID; servoPos[i] = SERVOMID;
}

// Initialize SD card
if (!SD.begin(SD_CS_PIN)) {
Serial.println("SD Card initialization failed!"); return;
}else{
Serial.println("SD Card initialized.");
}

// Connect to WiFi
WiFi.begin(ssid, password); Serial.print("Connecting to WiFi"); while (WiFi.status() != WL_CONNECTED) { delay(1000);
Serial.print(".");
}
Serial.println("\nWiFi connected. IP address: "); Serial.println(WiFi.localIP());

// Define API routes
server.on("/api/toggle-led", HTTP_GET, handleToggleLED); // Endpoint to toggle LED server.on("/api/millis", HTTP_GET, handleGetMillis); // Endpoint to get uptime in millis server.on("/api/rgb", HTTP_GET, handleGetRGB);
server.on("/api/servo", HTTP_POST, setServoPosition);
server.on("/api/servo", HTTP_GET, getServoPosition);
server.on("/api/set-pwm", HTTP_POST, setServoPWM); server.on("/api/gcode", HTTP_POST, runGCodeCommandHandler); server.on("/api/gcode", HTTP_OPTIONS, handlePreflight);

// Route to serve files from the SD card
server.onNotFound(handleFileRequest); // Handle all other requests as file requests

// Start the web server
server.begin();
Serial.println("HTTP server started.");
}

void loop() {
//unsigned long timeMs = millis();

//must be first
if(timeToUpdateServo < millis()){
if(millis() - timeToUpdateServo > 25){ // show warning when loop is behind Serial.print("Warning, servo loop behind ");
Serial.print(millis() - timeToUpdateServo);
Serial.println("ms");
}

timeToUpdateServo = millis() + 16;

bool reachedGoad = true;
for(int i=0; i<16; i++){
if(abs(servoPos[i] - servoPosGoal[i]) < 3){ servoPos[i] = servoPosGoal[i];
}else{
if(servoPos[i] < servoPosGoal[i]){ servoPos[i]+=2;
}

if(servoPos[i] > servoPosGoal[i]){ servoPos[i]-=2;
}
}

//check if all motors reached the goal if(servoPos[i] != servoPosGoal[i]){ reachedGoad = false;
}

pwm.setPWM(i, 0, servoPos[i]);
}
busy = !reachedGoad;
digitalWrite(LED_PIN, busy);
}

// if(timeToGetColor < timeMs && !(timeToUpdateServo < timeMs-5)){
// | if(!readingInProgress){
// | tcs.setInterrupt(false); // Turn on LED, start the reading
// | readingInProgress = true;
// | timeToGetColor = timeMs + 5;
// | }else{
// | tcs.getRGB(&sns_red, &sns_green, &sns_blue);
// | tcs.setInterrupt(true); // Turn off LED
// | readingInProgress = false;
// | timeToGetColor = timeMs + 995;
// | int cid = findClosestColorId(sns_red, sns_green, sns_blue);
// | if(cid == 1){Serial.println("PURPLE");}else
// | if(cid == 2){Serial.println("RED");}else
// | if(cid == 3){Serial.println("ORANGE");}else
// | if(cid == 4){Serial.println("YELLOW");}else
// | if(cid == 5){Serial.println("GREEN");}
// | }
// }

//execute Serial commands
if (stringComplete) {
runGCodeCommand(inputString, false); // Process the command
inputString = ""; | // Clear the string for the next input
stringComplete = false; | // Reset the flag
}

runGCodeProgram();

// Handle client requests
server.handleClient();
}
// G-Code --------------------------------------------------
void runGCodeProgram(){
if(!busy && blockExecutionUntil < millis() && runGCodeExecution){

if (gCodePointer >= sizeof(program) / sizeof(program[0])) {

runGCodeCommand("STOP", false); return;
}

//trip leading spaces
// int i=0;
// while (i < program.length() && program.charAt(gCodePointer) == ' ') { // i++;
// }
String line = program[gCodePointer];
line.trim();
//String line = program[gCodePointer].substring(i);

if(isLineExecutable(line)){
| Serial.print("[G-Code] ["); Serial.print(line); Serial.print("]: "); runGCodeCommand(line, true);

}else{
| gCodePointer++;
}
}
}

bool isLineExecutable(const String& line) {
if (line.charAt(0) == ':' || line.charAt(0) == '/' || line.length() == 0 || line.charAt(0) == ' ') { return false;
}
return true;
}

// Executes G-Code command
void runGCodeCommand(const String& command, bool advanceProgram) {
// Find the first space to separate the command from the parameters int spaceIndex = command.indexOf(' ');
String gcodeCommand;
String parameters;

if (spaceIndex != -1) {
// Extract the command and parameters gcodeCommand = command.substring(0, spaceIndex); parameters = command.substring(spaceIndex + 1); } else {
// No parameters, the entire string is the command gcodeCommand = command;
parameters = "";
}

// Call the appropriate handler based on the command if (gcodeCommand.equals("G0")) { Serial.println(command);
handleG0Command(parameters);
if (advanceProgram) gCodePointer++; }
else
if (gcodeCommand.equals("G1")) { Serial.println(command);
handleG1Command(parameters);
if (advanceProgram) gCodePointer++;
}
else if (gcodeCommand.equals("COLOR")) { tcs.setInterrupt(false); // Turn on LED delay(10);
tcs.getRGB(&sns_red, &sns_green, &sns_blue); tcs.setInterrupt(true); // Turn off LED Serial.print("COLOR (");
Serial.print(sns_red);
Serial.print(", ");
Serial.print(sns_green);
Serial.print(", ");
Serial.print(sns_blue);
Serial.print(") is ID: ");
color_id = findClosestColorId(sns_red, sns_green, sns_blue);

Serial.println(color_id);
if (advanceProgram) gCodePointer++; }
else if(gcodeCommand.equals("JMP")){ jumpToLabel(":"+parameters);
}
else if(gcodeCommand.equals("WAIT")){
int waitTime = parameters.toInt(); blockExecutionUntil = millis() + waitTime; Serial.print("Waiting ");
Serial.print(waitTime);
Serial.println("ms");
if (advanceProgram) gCodePointer++; }
else if(gcodeCommand.equals("START")){ runGCodeExecution = true;
Serial.println("STARTING THE PROGRAM"); if (advanceProgram) gCodePointer++;
}
else if(gcodeCommand.equals("STOP")){ runGCodeExecution = false; gCodePointer = 0;
Serial.println("STOPPING THE PROGRAM"); }
else if(gcodeCommand.equals("PAUSE")){ runGCodeExecution = false; Serial.println("PAUSING THE PROGRAM"); }
else if(gcodeCommand.equals("IF")){ handleIfCondition(parameters);
if (advanceProgram) gCodePointer++; }
else if(gcodeCommand.equals("END")){ handleEndCondition();
if (advanceProgram) gCodePointer++;
}
else {
// Unknown command, handle error or ignore Serial.println("Unknown command: " + gcodeCommand); }
}

void handleG0Command(const String& command) {
// Map motor labels to motor numbers
const uint8_t motorMap[] = {'X', 'Y', 'Z', 'E'}; float x = 0;
float y = 0;
float z = 0;
float e = 0;
// Loop through each motor label
for (uint8_t i = 0; i < 4; i++) {
bool found = false;
double val = extractValue(command, motorMap[i], found); if (found) {
if(motorMap[i] == 'X') x = val;
if(motorMap[i] == 'Y') y = val;
if(motorMap[i] == 'Z') z = val; if(motorMap[i] == 'E') e = val; }
}
Serial.println("----");
Serial.print("Solving IK for position "); Serial.print("X:");
Serial.print(x);
Serial.print(", Y:");
Serial.print(y);
Serial.print(", Z:");
Serial.println(z);

solveIK3D(x, y, z);

Position p = calculatePosition(numLinks); Serial.print("Reached to X:"); Serial.print(p.x);

Serial.print(", Y:");
Serial.println(p.y);
}

void handleG1Command(const String& command) {
// Map motor labels to motor numbers
const uint8_t motorMap[] = {'A', 'B', 'C', 'D', 'E', 'F', 'G', 'H', 'I', 'J', 'K', 'L', 'M', 'N', 'O', 'P'};

// Loop through each motor label
for (uint8_t i = 0; i < 16; i++) {
bool found = false;
double angle = extractValue(command, motorMap[i], found); if (found) {
// Set the servo position for the specific motor setServoPos(i, angle);
}
}
}

// Function to extract a value for a specific parameter (e.g., 'A', 'B', etc.) double extractValue(const String& command, char param, bool& found) {
int index = command.indexOf(param);
if (index != -1) {
int endIndex = command.indexOf(' ', index + 1); // Find end of the value if (endIndex == -1) endIndex = command.length(); // Last parameter String value = command.substring(index + 1, endIndex);
found = true;
return value.toDouble(); // Convert to double
}
found = false;
return 0.0;
}

void jumpToLabel(const String& label) {
for (int i = 0; i < sizeof(program) / sizeof(program[0]); i++) { if (program[i].equals(label)) {
gCodePointer = i + 1;
Serial.print("Jumping to '");
Serial.print(label);
Serial.print("'at line: "); Serial.println(gCodePointer); break;
}
}
}

//EXAMPLE
//COLOR == 1
void handleIfCondition(const String& parameters) {
// Increment the IF stack
ifStack++;

// Find the operator ("==", "!=") and split the condition and value int operatorIndex1 = parameters.indexOf("==");
int operatorIndex2 = parameters.indexOf("!=");
bool conditionResult = false;

if (operatorIndex1 == -1 && operatorIndex2 == -1) { Serial.print("Invalid condition: ");
return;
}

String condition = parameters.substring(0, max(operatorIndex1, operatorIndex2)); condition.trim();

if(operatorIndex1 > 0){
String value = parameters.substring(operatorIndex1 + 2);
value.trim();
int targetValue = value.toInt();
if(targetValue == color_id){
conditionResult = true;
}
}

if(operatorIndex2 > 0){
String value = parameters.substring(operatorIndex2 + 2); value.trim();
int targetValue = value.toInt();
if(targetValue == color_id){
conditionResult = true;
}
}

// Log the evaluation result
if (conditionResult) {
Serial.print("IF CONDITION '"); Serial.print(parameters);
Serial.println("' IS TRUE!"); } else {
Serial.print("IF CONDITION '"); Serial.print(parameters);
Serial.println("' IS FALSE!"); skipUntilEnd(); // Skip to the next END block }
}

void handleEndCondition() {
Serial.println("IF END");
ifStack--;
if (ifStack < 0) {
Serial.println("Unmatched END in G-code"); runGCodeExecution = false;
}
}

void skipUntilEnd() {
while (gCodePointer < sizeof(program) / sizeof(program[0])) { if (program[gCodePointer].equals("END")) {
gCodePointer++;
break;
}
gCodePointer++;
}
}

// This function is called when serial data is received
void serialEvent() {
while (Serial.available()) {
char inChar = (char)Serial.read(); // Read the incoming byte // If a newline character is detected, set the flag
if (inChar == '\n') {
stringComplete = true;
}else{
inputString += inChar;
}
}
}

int findClosestColorId(float r, float g, float b) {
float minDistance = 999999.0; // Initialize to a large number
int closestId = 0; // Default to no match

for (int i = 0; i < numColors; i++) {
// Calculate the Euclidean distance between the input color and each color in the list float distance = sqrt(pow(r - colorList[i].r, 2) + pow(g - colorList[i].g, 2) + pow(b -colorList[i].b, 2));

// Check if the distance is the smallest so far and within a reasonable threshold
if (distance < minDistance && distance < 15) {
minDistance = distance;
closestId = i; // Store the index of the closest color
}
}

return closestId;
}

void solveIK3D(float x, float y, float z){ y = y-50; //move target by 50mm for 2D IK float baseRot = atan2(z, x);
float distToY = sqrt(x * x + z * z); solveIK(distToY, -y);

Serial.print("2D IK space: ("); Serial.print(distToY);
Serial.print(", ");
Serial.print(y);
Serial.println(")");

float br = mymap(baseRot, 0, M_PI, 180, 0); Serial.print("Base rot: "); Serial.print(baseRot);
Serial.print("rad, ");
Serial.print(br);
Serial.println("deg");

// Print the joint angles
for (int i = 0; i < numLinks; i++) { Serial.print("Angle ");
Serial.print(i + 1);
Serial.print(": ");
Serial.print(linkAnglesIK[i]);
Serial.print("rad, ");
if(i==0){
Serial.print(mymap(linkAnglesIK[i], -M_PI, 0, 0, 180)); //conver to deg }else{
Serial.print(mymap(linkAnglesIK[i], -M_PI/2, M_PI/2, 0, 180)); //conver to deg }
Serial.println("deg");
}

setServoPos(0, br);
setServoPos(1, mymap(linkAnglesIK[0], -M_PI, 0, 180, 0)); setServoPos(2, mymap(linkAnglesIK[1], -M_PI/2, M_PI/2, 180, 0)); setServoPos(3, mymap(linkAnglesIK[2], -M_PI/2, M_PI/2, 180, 0)); }

// Function to calculate the position of the end of the chain Position calculatePosition(int iter) {
float x = 0;
float y = 0;
float angleSum = 0;

for (int i = 0; i < iter && i < numLinks; i++) { angleSum += linkAnglesIK[i];
x += linkLengths[i] * cos(angleSum);
y += linkLengths[i] * sin(angleSum);
}

Position result = {x, y};
return result;
}

// Cyclic Coordinate Descent (CCD) implementation void solveIK(float targetX, float targetY) { linkAnglesIK[0] = -1.57;
linkAnglesIK[1] = 0;
linkAnglesIK[2] = 1.57;
for (int iter = 0; iter < 100; iter++) {
for (int i = numLinks - 1; i >= 0; i--) {
Position currentPos = calculatePosition(numLinks); // End effector position
float distToTarget = sqrt(pow(currentPos.x - targetX, 2) + pow(currentPos.y - targetY, 2));

// Check if within tolerance
if (distToTarget < tolerance) {
Serial.println("Target reached.");
return;
}

Position jointPos = calculatePosition(i); // Position of the current joint

// Vectors
float jointToEffectorX = currentPos.x - jointPos.x; float jointToEffectorY = currentPos.y - jointPos.y; float jointToTargetX = targetX - jointPos.x;
float jointToTargetY = targetY - jointPos.y;

// Normalize vectors
float effectorLength = sqrt(jointToEffectorX * jointToEffectorX + jointToEffectorY * jointToEffectorY);
float targetLength = sqrt(jointToTargetX * jointToTargetX + jointToTargetY * jointToTargetY);

jointToEffectorX /= effectorLength;
jointToEffectorY /= effectorLength;
jointToTargetX /= targetLength;
jointToTargetY /= targetLength;

// Compute angle between vectors
float dot = jointToEffectorX * jointToTargetX + jointToEffectorY * jointToTargetY; float det = jointToEffectorX * jointToTargetY - jointToEffectorY * jointToTargetX; float angleChange = atan2(det, dot);

// Update joint angle
linkAnglesIK[i] += angleChange;

// Clamp joint angles within limits float minAngle = -M_PI / 2;
float maxAngle = M_PI / 2;
if (i == 0) {
minAngle = -M_PI;
maxAngle = 0;
}

if (linkAnglesIK[i] < minAngle) { linkAnglesIK[i] = minAngle;
}
if (linkAnglesIK[i] > maxAngle) { linkAnglesIK[i] = maxAngle;
}
}
}

Serial.println("IK did not converge within the iteration limit.");
}

float mymap(float x, float in_min, float in_max, float out_min, float out_max) { return (x - in_min) * (out_max - out_min) / (in_max - in_min) + out_min;
}

## Web Interface Code

HTML
<!DOCTYPE html>
<html lang="en">
<head>
<meta charset="UTF-8">
<meta name="viewport" content="width=device-width, initial-scale=1.0"> <title>Robot</title>
<script
src="https://cdnjs.cloudflare.com/ajax/libs/p5.js/1.4.0/p5.js"></script> <style>
* {
font-family: Roboto-Regular, Arial, Helvetica, sans-serif; color: #fff;
background-color: #000000;
}

#canvas-container {

display: flex;
justify-content: center;
align-items: center;
height: 500px;
width: 800px;
border: 1px solid rgb(53, 53, 53); margin-bottom: 20px;
}

#gui {

display: flex;
justify-content: center;
align-items: center;
flex-direction: column;
}

#dark {

color: #6e6e6e;
}

#gui span {

color: #6e6e6e;
}

#gui label {

color: #ffffff;
}

#slider-container {

display: flex;
justify-content: center;
align-items: left;
width: 800px;
flex-direction: column;
}

#buttons-container {

display: flex;
gap: 5px;
align-items: center;
flex-direction: row;
}

#heart-beat {

width: 25px;
height: 25px;
border-radius: 50%;
background-color: #55dd16; }

input[type=range] {
width: 100%;
margin: 5px 0;
}

input[type=checkbox] {
margin: 5px 0;
}

input[type=text] {
width: 400px;
margin: 5px 0;
font-size: 20px;
color: #dadada;
background-color: #1b1b1b; border: 1px solid #8f8f8f; }

button {
width: 100px;
margin: 5px 0;
font-size: 20px;
color: #ffffff;
background-color: #1b1b1b; border: 1px solid #8f8f8f; cursor: pointer;
}
</style>
</head>
<body>
<main>
<div id="gui">
<h1>Robot arm control panel</h1>
<div id="canvas-container"></div> <!-- Canvas will go here --> <div id="slider-container">
<span id="dark">Viewport: <span id="fps-value">60</span>fps</span><br>
<!-- <label for="motor1">Motor 1 <span id="dark">(<span id="motor1-value">90</span>°)</span></label> <input type="range" id="motor1" min="0" max="180" value="90"> -->
<label for="gcode-input">Run G-Code Command:</label>
<div id="slider-container", style="display: block;">
<input type="text" id="gcode-input" name="gcode-input" value="G1 A90 B90 C90 D90 E90 F0"> <button id="run-gcode">SEND</button>
</div>

<div id="buttons-container">
<button id="start-robot">START</button> <button id="pause-robot">PAUSE</button>
<button id="stop-robot">STOP</button>
<!-- sync with robot cehckbox -->
<input type="checkbox" id="sync-robot" name="sync-robot" value="sync-robot">
<label for="sync-robot">Sync with robot</label>
<div id="heart-beat"></div>
</div>
<br>
<label for="eepos-value">End effector position: &nbsp; <span id="dark"><span id="eepos-value">0</span></span></label>

</div>
</div>
</main>
<script src="sketch.js"></script> </body>
</html>

JavaScript

let runGCodeButton;
let gcodeInput;
let heartBeatDiv;
let heartBeatTime = 0;
let syncCheckbox;

let motors = {
m0: 90,
m1: 90,
m2: 90,
m3: 90,
m4: 90
};

let motorsGoal = {
m0: 90,
m1: 90,
m2: 90,
m3: 90,
m4: 90
};

let gripperClosed = true;
let myFont;
let timeToUpdate = 0;
let togglePos = false;

//camera controls
let cam;
let isPanning = false;
let lastMouseX, lastMouseY; let camAngle = 90;
let camHeight = 150;
let zoomLevel = 200;
let zoomGoal = 200;

endEffectorPos = {
x: 0,
y: 0,
z: 0
};

//let server = "https://robot.xpiti.com";//let server = "http://192.168.1.193";
let server = "";

let filesToLoad = [
{ type: 'model', key: 'armModelSeg0', path: 'arm/0.stl' },
{ type: 'model', key: 'armModelSeg1', path: 'arm/1.stl' },
{ type: 'model', key: 'armModelSeg2', path: 'arm/23.stl' },
{ type: 'model', key: 'armModelSeg3', path: 'arm/23.stl' }, // armModelSeg3 reuses armModelSeg2 { type: 'model', key: 'armModelSeg4', path: 'arm/4.stl' },
{ type: 'model', key: 'armModelSeg4_open', path: 'arm/4_open.stl' },
{ type: 'image', key: 'armTexture', path: 'arm/arm_texture.png' }
// { type: 'font', key: 'myFont', path: 'Roboto-Regular.ttf' },
];

let assets = {}; // To store loaded assets
let retryLimit = 3;
let filesLoaded = false;

function loadFileSequentially(index = 0, retries = 0) { if (index >= filesToLoad.length) {
console.log("All files loaded successfully!"); filesLoaded = true;
// start syncing with the robot (enable the checkbox) syncCheckbox.checked(true);
return;
}

let file = filesToLoad[index];
console.log(`Loading ${file.type} from ${file.path}...`);

// Choose the correct loading function based on type
let loadFunction;
switch (file.type) {
case 'model':
loadFunction = loadModel;
break;
case 'image':
loadFunction = loadImage;
break;
case 'font':
loadFunction = loadFont;
break;
default:
console.error(`Unknown type: ${file.type}`); return;
}

// Load the file
loadFunction(file.path,
(loadedAsset) => {
// Success
assets[file.key] = loadedAsset; console.log(`${file.key} loaded successfully.`);
// Handle cases like armModelSeg3 depending on another if (file.key === 'armModelSeg3') {
assets[file.key] = assets['armModelSeg2'];
}
loadFileSequentially(index + 1);
},
(err) => {
// Failure
if (retries < retryLimit) {
console.warn(`Retrying to load ${file.path}... Attempt ${retries + 1}`); loadFileSequentially(index, retries + 1);
} else {
console.error(`Failed to load ${file.path} after ${retryLimit} attempts.`); loadFileSequentially(index + 1); // Skip to the next file
}
}
);
}

function setup() {
// Select the container element
const container = document.getElementById("canvas-container");

// Get the container's width and height
const width = container.offsetWidth;
const height = container.offsetHeight;

// Create the canvas with the container's dimensions canvas = createCanvas(width, height, WEBGL);

// Place the canvas in the container canvas.parent("canvas-container");

cam = createCamera();
setCamera(cam);

//------------------------------------------------

// Link the slider from the HTML to the JavaScript runGCodeButton = select('#run-gcode'); runGCodeButton.mousePressed(processGCodeInput); gcodeInput = select('#gcode-input'); gcodeInput.changed(processGCodeInput);

//start pause and stop buttons
let startButton = select('#start-robot'); startButton.mousePressed(() => { sendGCodeCommand("START");
});
let pauseButton = select('#pause-robot'); pauseButton.mousePressed(() => { sendGCodeCommand("PAUSE");
});
let stopButton = select('#stop-robot'); stopButton.mousePressed(() => { sendGCodeCommand("STOP");
});

syncCheckbox = select('#sync-robot'); heartBeatDiv = select('#heart-beat');

// armModelSeg0 = loadModel('arm/0.stl'); // armModelSeg1 = loadModel('arm/1.stl'); // armModelSeg2 = loadModel('arm/23.stl');
// armModelSeg3 = armModelSeg2;
// armModelSeg4 = loadModel('arm/4.stl');
// armModelSeg4_open = loadModel('arm/4_open.stl'); // armTexture = loadImage('arm/arm_texture.png'); // myFont = loadFont('Roboto-Regular.ttf');

loadFileSequentially();

//textFont(myFont);

angleMode(DEGREES);

print("Setup complete");
}

function windowResized() {
// Recalculate the dimensions when the window is resized const container = document.getElementById("canvas-container"); const width = container.offsetWidth;
const height = container.offsetHeight;

// Resize the canvas to fit the container
resizeCanvas(width, height);
}

function processGCodeInput(){
let gcode = document.getElementById("gcode-input").value; sendGCodeCommand(gcode);
}

// Function to fetch motor positions (non-blocking) function fetchMotorPositions() {
// Make a GET request to the server fetch(`${server}/api/servo`)
.then(response => {
// Check if the response is ok
if (!response.ok) {
throw new Error(`HTTP error! status: ${response.status}`); }
return response.json(); // Parse JSON response
})
.then(motorData => {
// Update the motor variables
// check if the motorData is not empty if(motorData.servo0 == undefined){ return;
}

motorsGoal.m0 = motorData.servo0; motorsGoal.m1 = motorData.servo1; motorsGoal.m2 = motorData.servo2; motorsGoal.m3 = motorData.servo3; motorsGoal.m4 = motorData.servo4; gripperClosed = motorData.servo4 > 85;

heartBeatTime = millis();

//console.log('Motor positions updated:', motors);
})
.catch(error => {
console.error('Error fetching motor positions:', error); });
}

// Function to send a G-Code command (non-blocking) with retries function sendGCodeCommand(cmd) {
// Define the endpoint
const endpoint = `${server}/api/gcode`;

const payload = {
command: cmd, // The G-Code command string
};

console.log("Sending G-Code command:", JSON.stringify(payload));

// Define the maximum number of retries
const maxRetries = 3;

// Function to attempt the request function attemptRequest(retriesLeft) {
// Make a POST request to the server fetch(endpoint, {
method: "POST", // Use the POST HTTP method
headers: {
"Content-Type": "application/json", // Specify JSON content type },
body: JSON.stringify(payload), // Convert the payload to JSON
})
.then(response => {
// Check if the response is ok
if (!response.ok) {
throw new Error(`HTTP error! status: ${response.status}`); }
return response.json(); // Parse JSON response
})
.then(data => {
// Handle the server's response
console.log("G-Code command sent successfully:", data); gcodeInput.style('background-color', '#1b1b1b');
})
.catch(error => {
console.error(`Error sending G-Code command: ${error}`);

// Retry if there are retries left
if (retriesLeft > 0) {
console.log(`Retrying... Attempts left: ${retriesLeft}`); attemptRequest(retriesLeft - 1); // Retry the request
} else {
console.error("Max retries reached. G-Code command failed."); gcodeInput.style('background-color', '#c21717');
}
});
}

// Start the first attempt with maxRetries attemptRequest(maxRetries);
}

function draw() {
background(20);

let hbt = millis() - (heartBeatTime + 500);
hbt = constrain(hbt, 0, 1000);
let heartBeatColor = map(hbt, 0, 2000, 200, 20); heartBeatDiv.style('background-color', `rgb(0, ${heartBeatColor}, 0)`);

if(timeToUpdate < millis()){
timeToUpdate = millis() + 1000;
if(syncCheckbox.checked()){
fetchMotorPositions();
}
}

if(filesLoaded){
//lerp motors for smooth visualisation
motors.m0 = movePosition(motors.m0, motorsGoal.m0, 1); motors.m1 = movePosition(motors.m1, motorsGoal.m1, 1); motors.m2 = movePosition(motors.m2, motorsGoal.m2, 1); motors.m3 = movePosition(motors.m3, motorsGoal.m3, 1);

endEffectorPos = getEndEffectorPosition();

// Drawing
push();
lights();
//translate(0, 100, 0); // Move the camera back // rotateX(-22);
// rotateY(30*sin(frameCount/2));
scale(1, -1, 1);
drawAxes(this, 100);
drawGrid(this, 500, 10);
drawGrid(this, 1000, 50);
drawScene(this, endEffectorPos);
pop();

document.getElementById("fps-value").textContent = round(frameRate()); document.getElementById("eepos-value").textContent = `x: ${round(endEffectorPos.x)}mm, y: ${round(endEffectorPos.y)}mm, z: ${round(endEffectorPos.z)}mm`;
}else{
noFill();
stroke(255);
strokeWeight(3);

let rot = millis() / 2;
let a1 = map(sin(millis()/5), -1, 1, 0, 180) + rot; let a2 = map(sin(millis()/6), -1, 1, 180, 360) + rot; arc(0, -75, 50, 50, a1, a2);
noStroke();
fill(50);
box(200, 1, 100);
}

//lerp zoom
zoomLevel = lerp(zoomLevel, zoomGoal, 0.05);
// Handle rotation when no key is pressed
if (mouseIsPressed && mouseX > 0 && mouseX < width && mouseY > 0 && mouseY < height) { let dx = mouseX - lastMouseX;
let dy = mouseY - lastMouseY;
camAngle += dx * 0.1;
camHeight += dy * 0.5;
camHeight = constrain(camHeight, 0, 500);
}

cam.camera(cos(camAngle)*zoomLevel, -camHeight, sin(camAngle)*zoomLevel, 0, -camHeight/2, 0, 0, 1, 0);

// Update the last mouse position for rotation
lastMouseX = mouseX;
lastMouseY = mouseY;
}

function animateRoot(){
motors.m0 = ( sin(frameCount/3.22) * 90 ) + 90;
motors.m1 = ( (sin(frameCount/3.9112) * sin(frameCount/1.432)) * 90 ) + 90;

motors.m2 = ( sin(frameCount/1.55) * 90 ) + 90; motors.m3 = ( sin(frameCount/2.32) * 90 ) + 90; }

function drawGrid(buffer, size, spacing){
let gridCount = size/spacing/2;

buffer.stroke(255, 33);
buffer.strokeWeight(1);
for(let i = -gridCount; i <= gridCount; i++){
buffer.line(-spacing * gridCount, 0, i * spacing, spacing * gridCount, 0, i * spacing); buffer.line(i * spacing, 0, -spacing * gridCount, i * spacing, 0, spacing * gridCount); }
}

function drawScene(buffer, eePos){
// Draw the robot arm
drawRobot(buffer, motors);

// Draw the end effector position buffer.push();
buffer.fill(255, 0, 0);
buffer.translate(eePos.x, eePos.y, eePos.z); buffer.sphere(3);
drawAxes(buffer, 20);
buffer.pop();

buffer.push();

buffer.stroke(0);
buffer.fill(100, 0, 150);
buffer.translate(-72, 15, 100); buffer.box(30, 30, 50);

buffer.fill(200, 0, 0);
buffer.translate(33.5, 0, 0); buffer.box(30, 30, 50);

buffer.fill(255, 150, 0);
buffer.translate(33.5, 0, 0); buffer.box(30, 30, 50);

buffer.fill(255, 255, 0);
buffer.translate(33.5, 0, 0); buffer.box(30, 30, 50);

buffer.fill(0, 255, 0);
buffer.translate(33.5, 0, 0); buffer.box(30, 30, 50);

buffer.pop();
}

function drawRobot(buffer, robotMotors) {
let m0 = map(robotMotors.m0, 0, 180, -90, 90); let m1 = map(robotMotors.m1, 180, 0, -90, 90); let m2 = map(robotMotors.m2, 180, 0, -90, 90); let m3 = map(robotMotors.m3, 180, 0, -90, 90);

let segmentHeight = 50; // Height of each segment

//buffer.texture(armTexture);
buffer.fill(255);
buffer.noStroke();

// --- Arm Segment 0 (Base) ---
buffer.push();

buffer.model(assets["armModelSeg0"]); // Draw stationary base buffer.pop();

// --- Arm Segment 1 ---

buffer.push();
buffer.translate(0, segmentHeight, 0); // Move armModelSeg1 above the base by 46.25 mm
buffer.rotateY(m0); | // Rotate armModelSeg1 horizontally around Y-axis (base
rotation)
buffer.model(assets["armModelSeg1"]);

// --- Arm Segment 2 ---
buffer.rotateX(m1); | // Rotate armModelSeg2 vertically around X-axis
buffer.model(assets["armModelSeg2"]);

// --- Arm Segment 3 ---
buffer.translate(0, segmentHeight, 0); // Move armModelSeg3 above armModelSeg2 by 50mm
buffer.rotateX(m2); | // Rotate armModelSeg3 vertically around X-axis
buffer.model(assets["armModelSeg3"]);

// --- Arm Segment 4 (End Effector) ---
buffer.translate(0, segmentHeight, 0); // Move armModelSeg4 (end effector) above armModelSeg3 by 50mm
buffer.rotateX(m3); | // Rotate the end effector
if(gripperClosed){
buffer.model(assets["armModelSeg4"]);
}else{
buffer.model(assets["armModelSeg4_open"]); }

buffer.fill(0);

buffer.translate(0, segmentHeight, 0); // Move the end effector above armModelSeg4 by 50mm // drawAxes(10);
// buffer.fill(200);
// buffer.noStroke();
// buffer.sphere(3);

buffer.pop(); // End of robot arm drawing

buffer.fill(0);
}

function drawAxes(buffer, axisLength) { buffer.strokeWeight(1.5);
buffer.stroke(255, 0, 0);
buffer.line(0, 0, 0, axisLength, 0, 0); buffer.stroke(0, 255, 0);
buffer.line(0, 0, 0, 0, axisLength, 0); buffer.stroke(0, 0, 255);
buffer.line(0, 0, 0, 0, 0, axisLength);

buffer.noStroke();
buffer.push();
buffer.fill(255, 0, 0);
buffer.translate(axisLength, 0, 0); buffer.rotateZ(-90);
buffer.cone(3, 8);
buffer.pop();

buffer.push();
buffer.fill(0, 255, 0);
buffer.translate(0, axisLength, 0); buffer.cone(3, 8);
buffer.pop();

buffer.push();
buffer.fill(0, 0, 255);
buffer.translate(0, 0, axisLength); buffer.rotateX(90);
buffer.cone(3, 8);
buffer.pop();
}

function getEndEffectorPosition() {
// base is at 0,0,0,
let L1 = 50; //first segment, rotating horizontally let L2 = 50;
let L3 = 50;

let L4 = 75; //end effector

let A1 = 0 - motors.m0;
let A2 = motors.m1 - 180;
let A3 = 90 + motors.m1 + motors.m2;
let A4 = motors.m1 + motors.m2 + motors.m3;

let d = cos(A2)*L2 + cos(A3)*L3 + cos(A4)*L4;
let X = cos(A1) * d;
let Y = L1 + sin(A2)*L2 + sin(A3)*L3 + sin(A4)*L4; let Z = sin(A1) * d;

return {
x: X,
y: -Y + 100,
z: Z
}
}

function mouseWheel(event) {
// Zoom in/out when scrolling
zoomGoal += event.delta * 0.5; // Adjust zoom speed here
zoomGoal = constrain(zoomGoal, 50, 500); // Constrain zoom to desired limits }

function movePosition(pos, goal, speed){
if(abs(pos - goal) <= speed){
return goal;
}

if(pos < goal){
return pos + speed;
}else{
return pos - speed;
}
}
