Jvinuelapz/5DoF_Robotic_Arm/images/3D_Drawings/Skittle dispenser and sensor.png

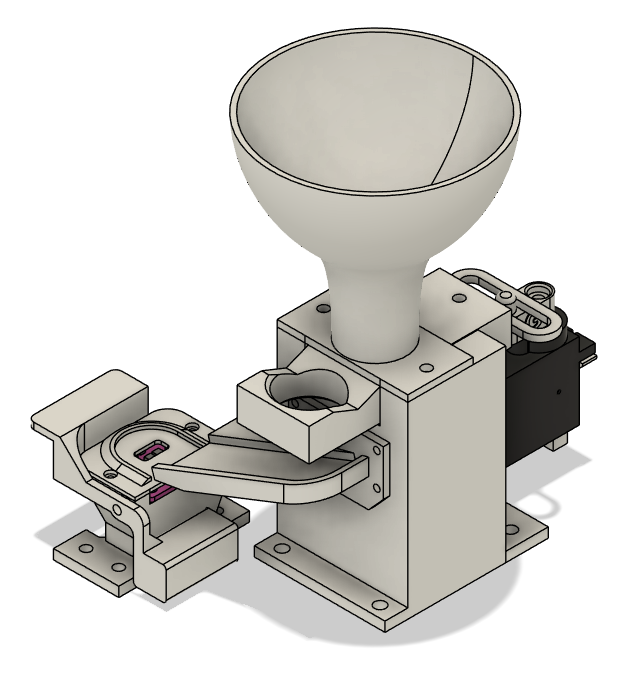
images/3D_Drawings/Skittle dispenser and sensor.png
