Jvinuelapz/5DoF_Robotic_Arm/images/Render.PNG

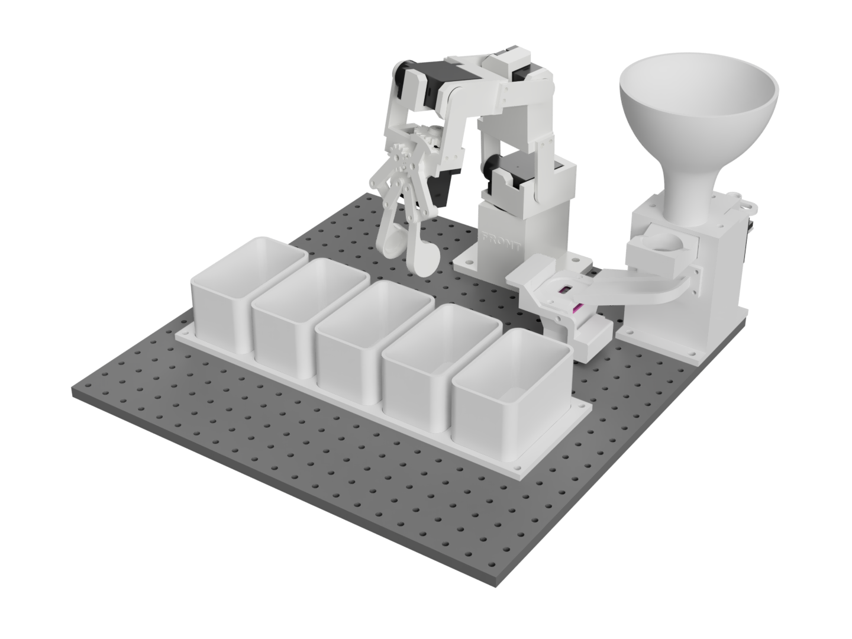
images/Render.PNG
