Jvinuelapz/5DoF_Robotic_Arm/Web_Interface/arm_texture.png

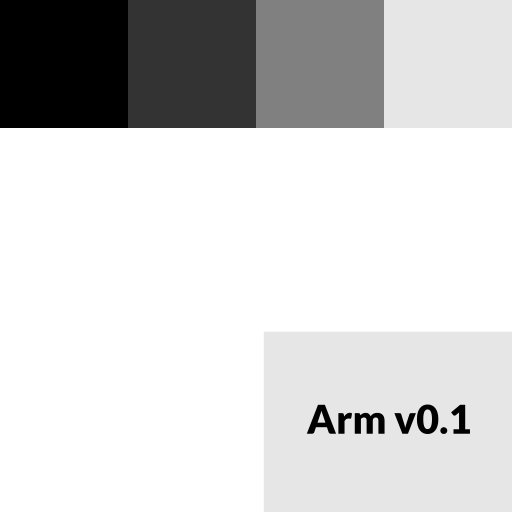
Web_Interface/arm_texture.png
