Jvinuelapz/5DoF_Robotic_Arm/Hardware_Design/Files_for_3D_Printing/Gripper Main Gear.stl

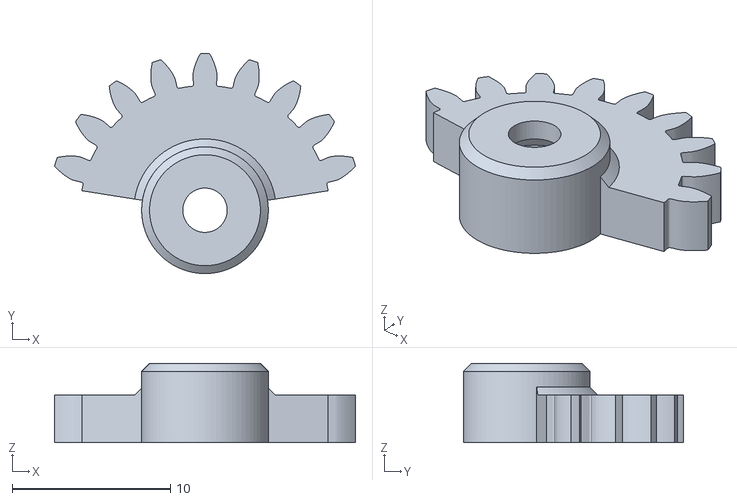
[picture p35: CAD file, 2025-07-15]
Hardware_Design/Files_for_3D_Printing/Gripper Main Gear.stl
19.0 x 13.9 x 5.00
