Jvinuelapz/5DoF_Robotic_Arm/Hardware_Design/Files_for_3D_Printing/Gripper Left Link.stl

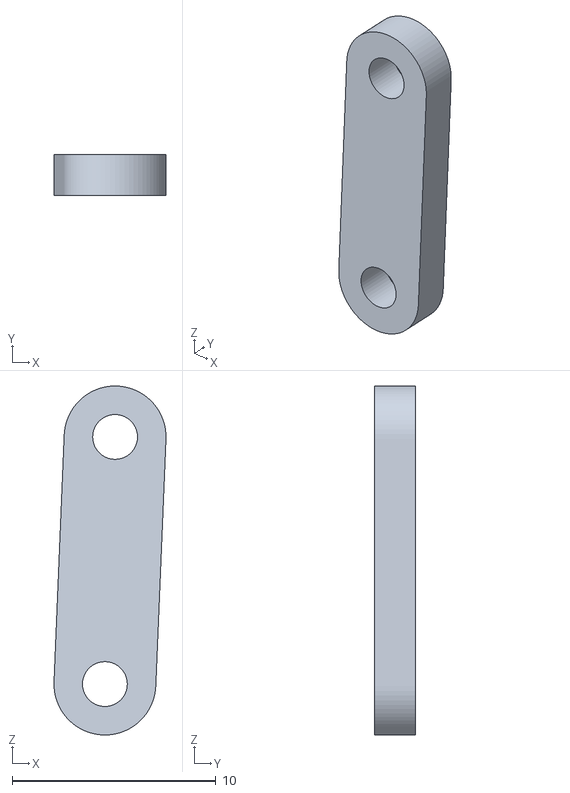
[picture p36: CAD file, 2025-07-15]
Hardware_Design/Files_for_3D_Printing/Gripper Left Link.stl
5.50 x 2.00 x 17.1
