Jvinuelapz/5DoF_Robotic_Arm/Web_Interface/0.stl

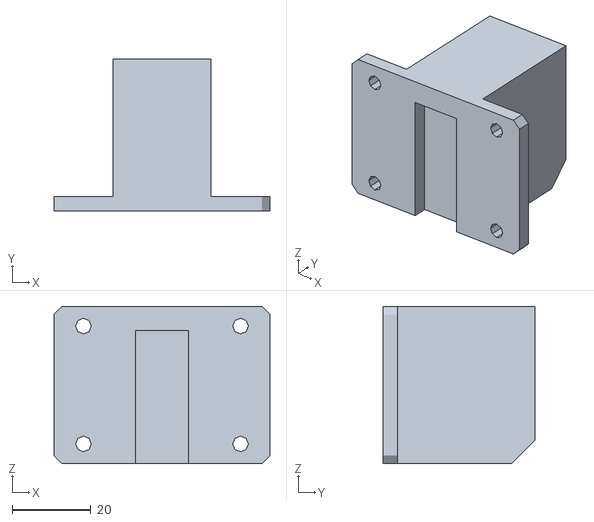
[picture p37: CAD file, 2025-07-15]
Web_Interface/0.stl
55.0 x 38.8 x 40.0
