Jvinuelapz/5DoF_Robotic_Arm/Web_Interface/23.stl

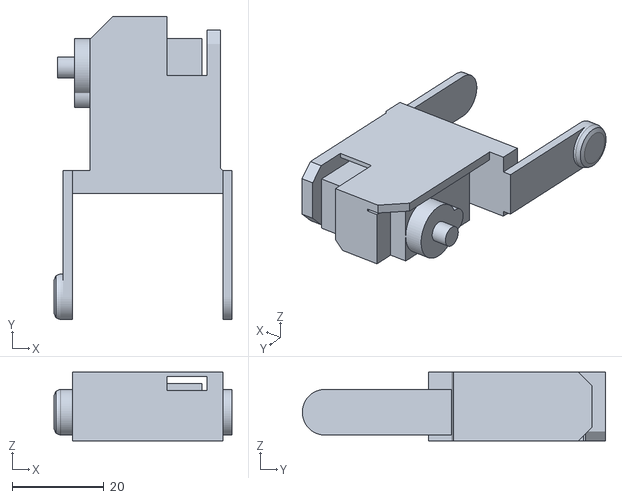
[picture p38: CAD file, 2025-07-15]
Web_Interface/23.stl
38.8 x 66.1 x 15.0
