Jvinuelapz/5DoF_Robotic_Arm/Hardware_Design/Files_for_3D_Printing/Segment2+3 Base.stl

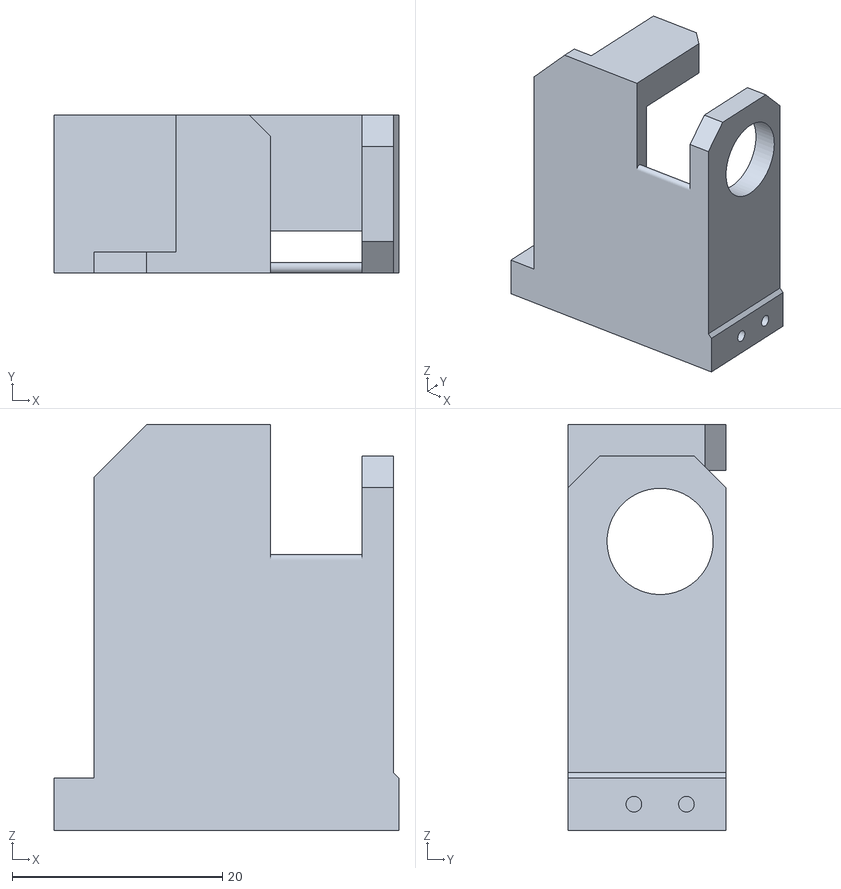
[picture p39: CAD file, 2025-07-15]
Hardware_Design/Files_for_3D_Printing/Segment2+3 Base.stl
32.8 x 15.0 x 38.6
