Jvinuelapz/5DoF_Robotic_Arm/Web_Interface/4.stl

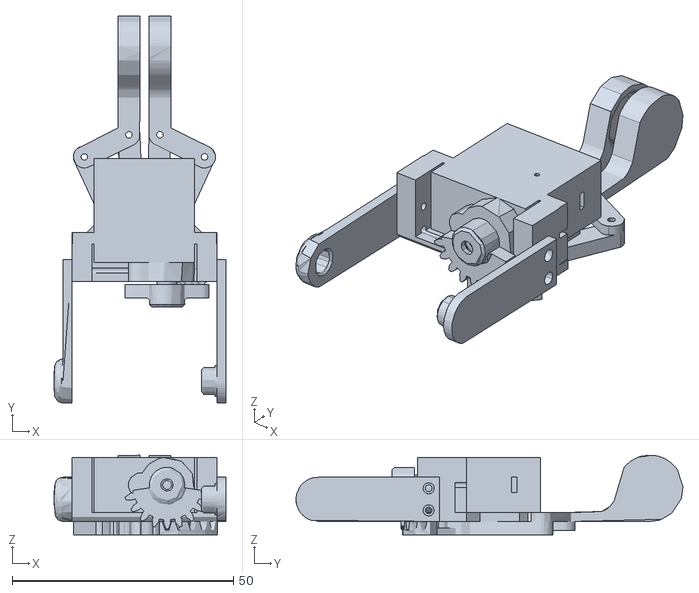
[picture p40: CAD file, 2025-07-15]
Web_Interface/4.stl
38.8 x 87.5 x 18.0
