Jvinuelapz/5DoF_Robotic_Arm/Hardware_Design/Files_for_3D_Printing/Gripper Base.stl

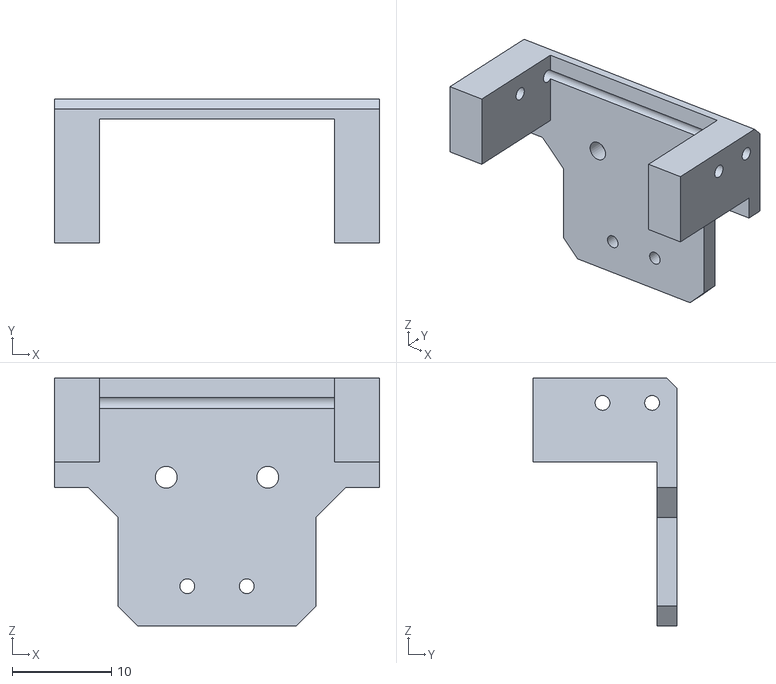
[picture p41: CAD file, 2025-07-15]
Hardware_Design/Files_for_3D_Printing/Gripper Base.stl
32.8 x 14.5 x 25.0
