Jvinuelapz/5DoF_Robotic_Arm/Web_Interface/1.stl

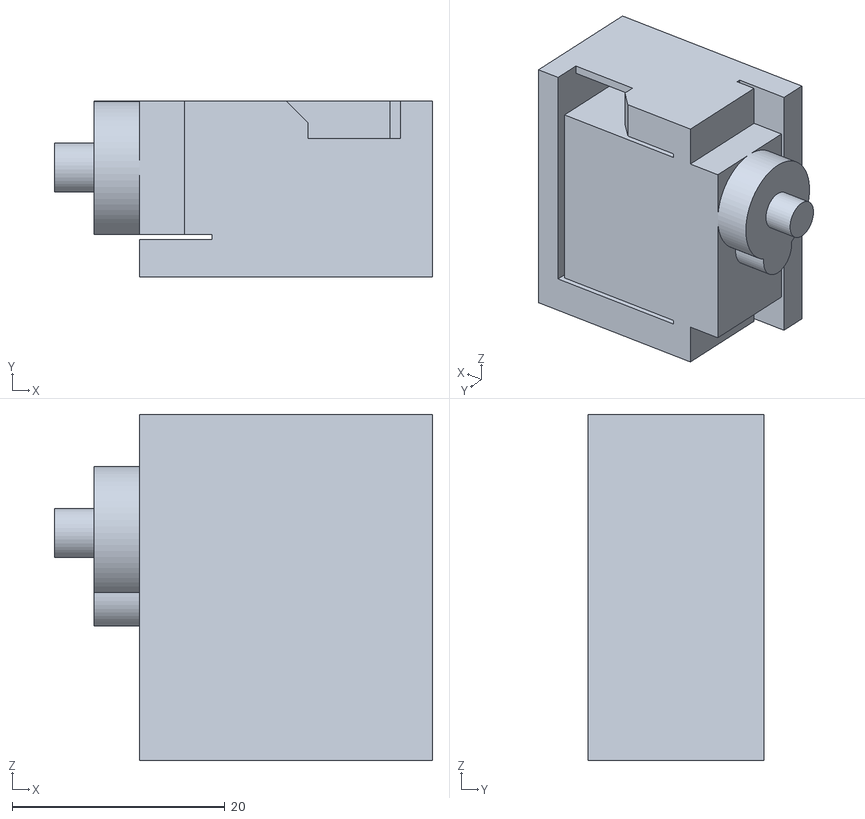
[picture p42: CAD file, 2025-07-15]
Web_Interface/1.stl
35.5 x 16.5 x 32.5
