Jvinuelapz/5DoF_Robotic_Arm/Hardware_Design/Files_for_3D_Printing/Bracket for boxes.stl

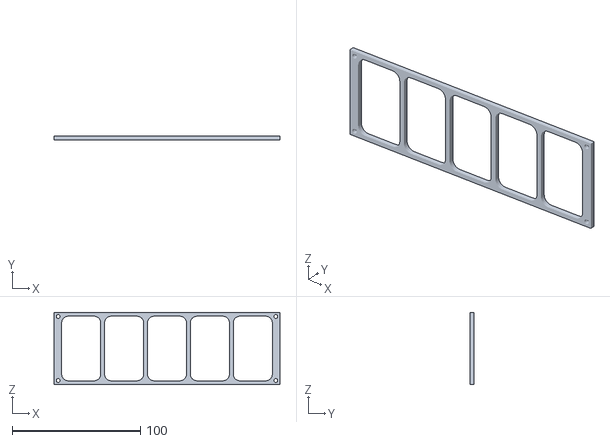
[picture p43: CAD file, 2025-07-15]
Hardware_Design/Files_for_3D_Printing/Bracket for boxes.stl
176.5 x 3.00 x 56.5
