Jvinuelapz/5DoF_Robotic_Arm/Web_Interface/4_open.stl

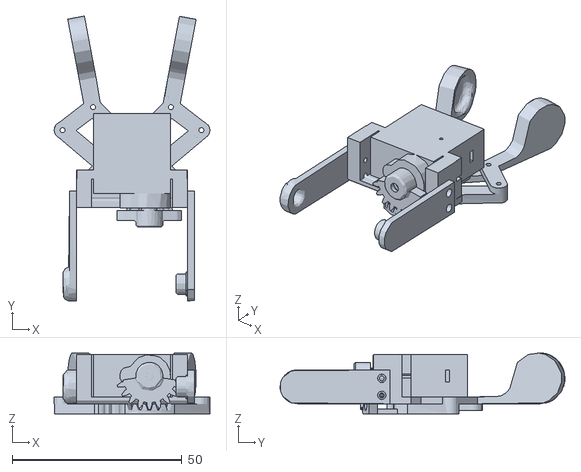
[picture p44: CAD file, 2025-07-15]
Web_Interface/4_open.stl
45.9 x 84.0 x 18.0
