Jvinuelapz/5DoF_Robotic_Arm/Hardware_Design/Files_for_3D_Printing/Gripper Right Gear Arm.stl

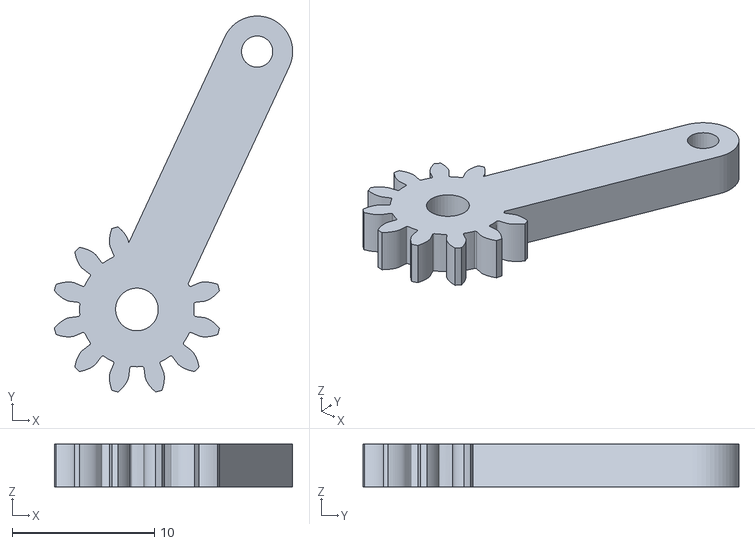
[picture p45: CAD file, 2025-07-15]
Hardware_Design/Files_for_3D_Printing/Gripper Right Gear Arm.stl
16.8 x 26.4 x 3.00
