Jvinuelapz/5DoF_Robotic_Arm/Hardware_Design/Files_for_3D_Printing/Motor Shaft Swing.stl

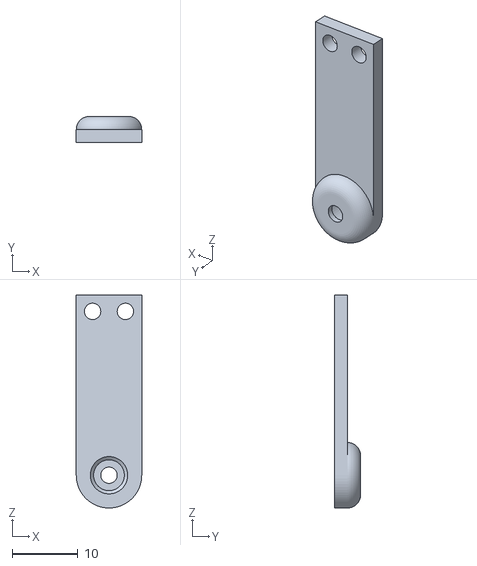
[picture p46: CAD file, 2025-07-15]
Hardware_Design/Files_for_3D_Printing/Motor Shaft Swing.stl
10.0 x 4.00 x 32.5
