Jvinuelapz/5DoF_Robotic_Arm/Hardware_Design/Files_for_3D_Printing/Gripper Left Clamp.stl

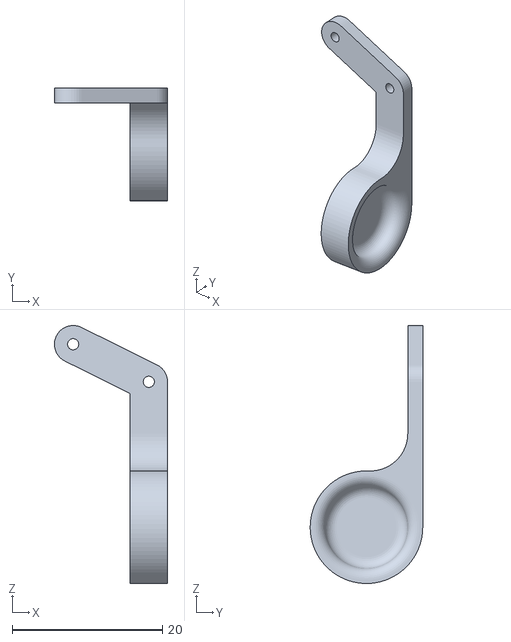
[picture p47: CAD file, 2025-07-15]
Hardware_Design/Files_for_3D_Printing/Gripper Left Clamp.stl
15.1 x 15.0 x 34.4
