Jvinuelapz/5DoF_Robotic_Arm/Hardware_Design/Files_for_3D_Printing/Servo Slider Swing.stl

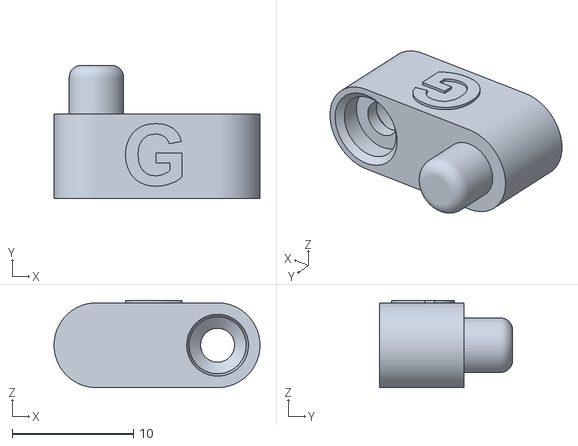
[picture p48: CAD file, 2025-07-15]
Hardware_Design/Files_for_3D_Printing/Servo Slider Swing.stl
17.0 x 11.0 x 7.20
