Jvinuelapz/5DoF_Robotic_Arm/Hardware_Design/Files_for_3D_Printing/Sensor Swing.stl

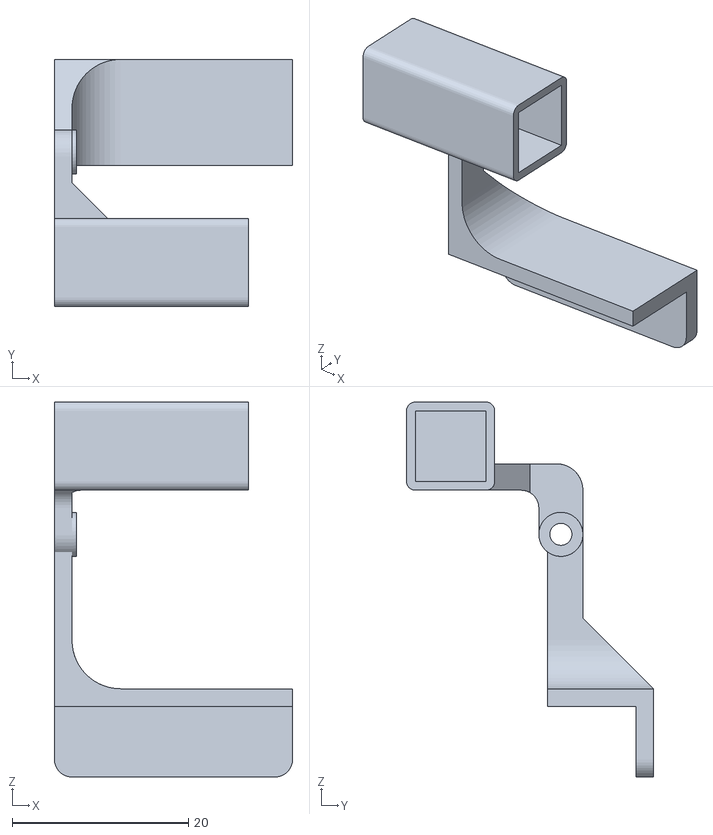
[picture p49: CAD file, 2025-07-15]
Hardware_Design/Files_for_3D_Printing/Sensor Swing.stl
27.0 x 28.0 x 42.5
