Jvinuelapz/5DoF_Robotic_Arm/Hardware_Design/Files_for_3D_Printing/PCB_Faceplate.stl

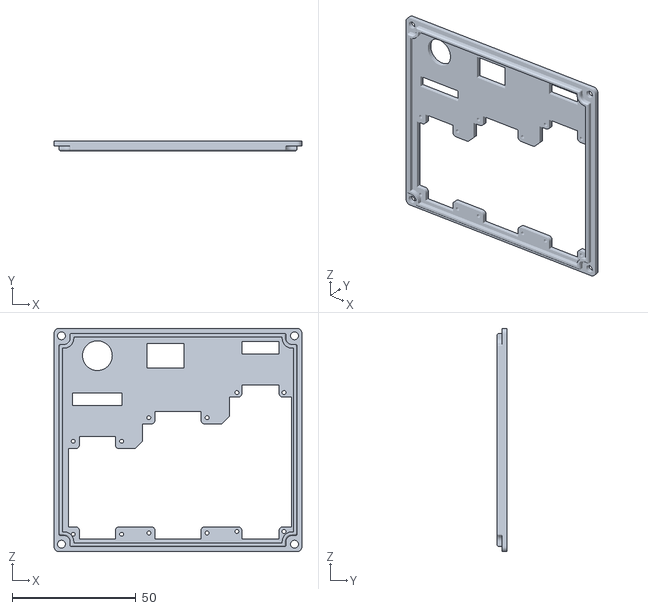
[picture p50: CAD file, 2025-07-15]
Hardware_Design/Files_for_3D_Printing/PCB_Faceplate.stl
100.0 x 4.00 x 90.0
