Jvinuelapz/5DoF_Robotic_Arm/Hardware_Design/Files_for_3D_Printing/Robot Base.stl

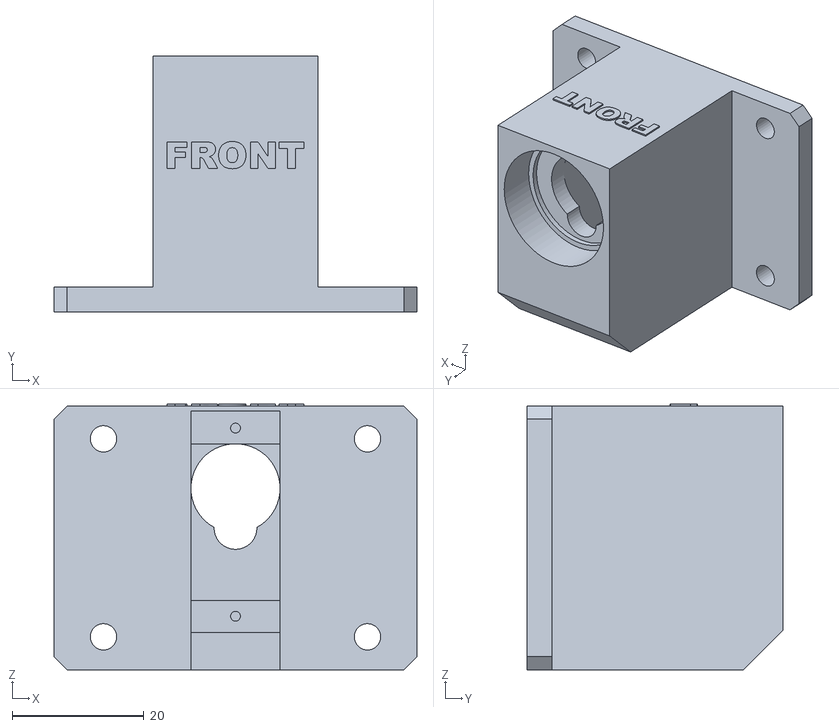
[picture p51: CAD file, 2025-07-15]
Hardware_Design/Files_for_3D_Printing/Robot Base.stl
55.0 x 38.8 x 40.2
