Jvinuelapz/5DoF_Robotic_Arm/Hardware_Design/Files_for_3D_Printing/Skittle Box.stl

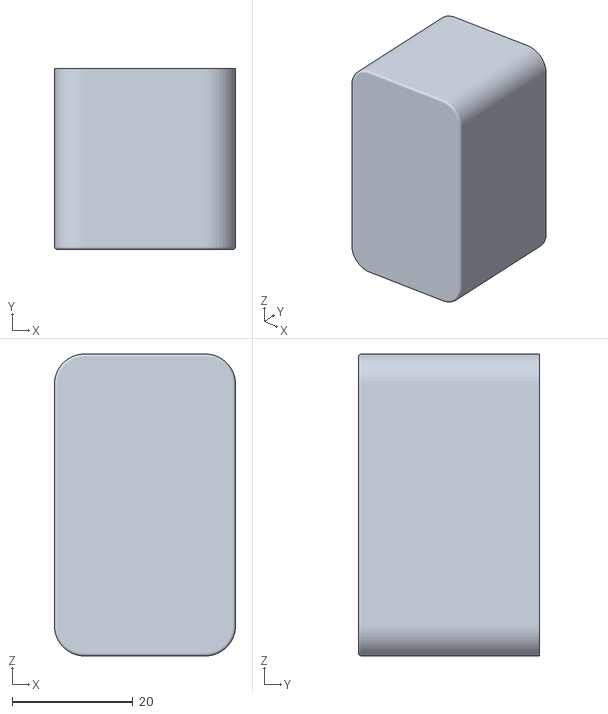
[picture p52: CAD file, 2025-07-15]
Hardware_Design/Files_for_3D_Printing/Skittle Box.stl
30.0 x 30.0 x 50.0
