Jvinuelapz/5DoF_Robotic_Arm/Hardware_Design/Files_for_3D_Printing/Dispenser Hopper.stl

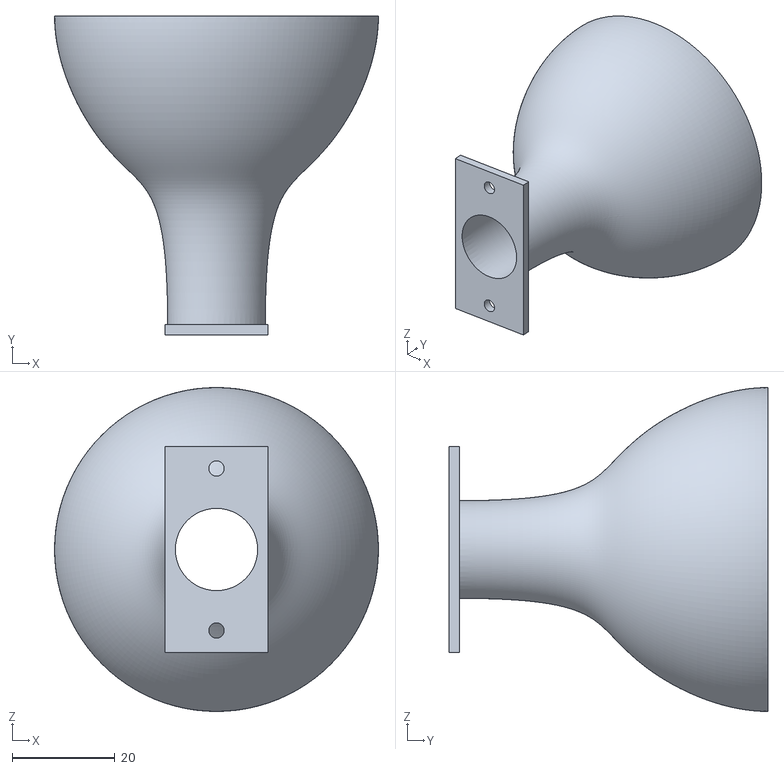
[picture p53: CAD file, 2025-07-15]
Hardware_Design/Files_for_3D_Printing/Dispenser Hopper.stl
63.0 x 62.0 x 63.0
