Jvinuelapz/5DoF_Robotic_Arm/Hardware_Design/Files_for_3D_Printing/Segment1 Base.stl

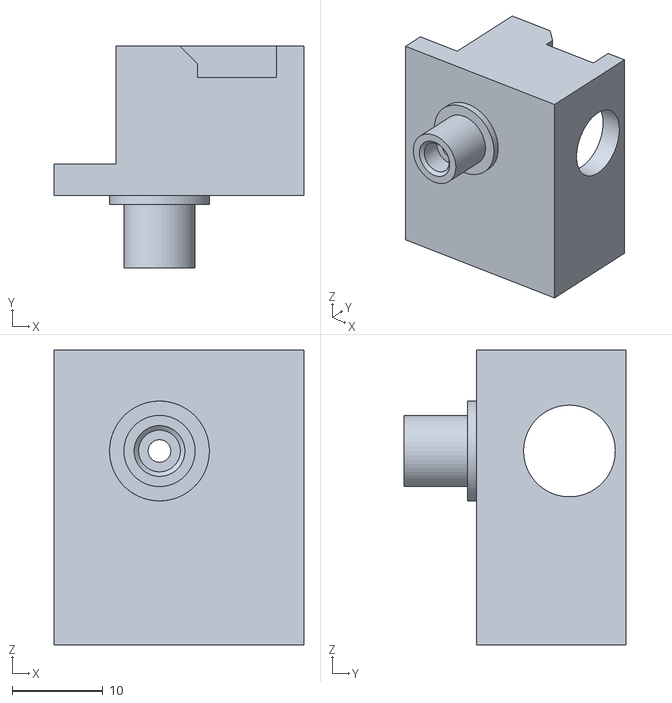
[picture p54: CAD file, 2025-07-15]
Hardware_Design/Files_for_3D_Printing/Segment1 Base.stl
27.5 x 24.5 x 32.5
