Jvinuelapz/5DoF_Robotic_Arm/Hardware_Design/Files_for_3D_Printing/Dispenser Base.stl

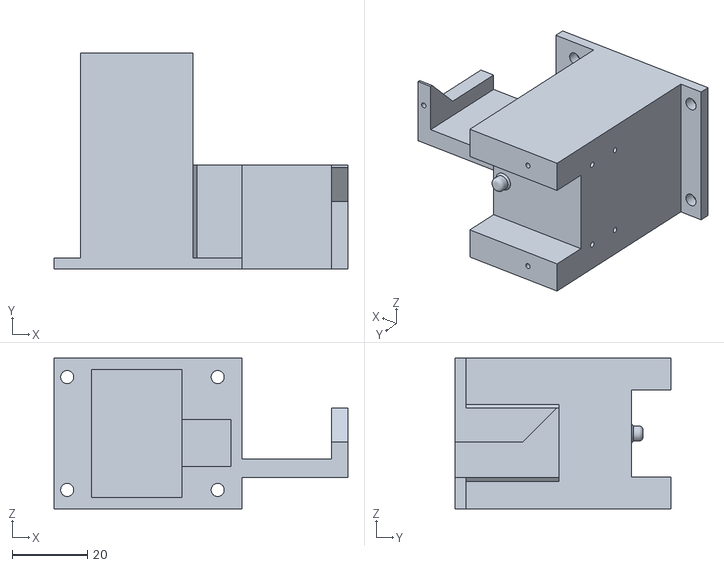
[picture p55: CAD file, 2025-07-15]
Hardware_Design/Files_for_3D_Printing/Dispenser Base.stl
78.1 x 57.5 x 40.0
