Jvinuelapz/5DoF_Robotic_Arm/Hardware_Design/Files_for_3D_Printing/Gripper Left Gear Arm.stl

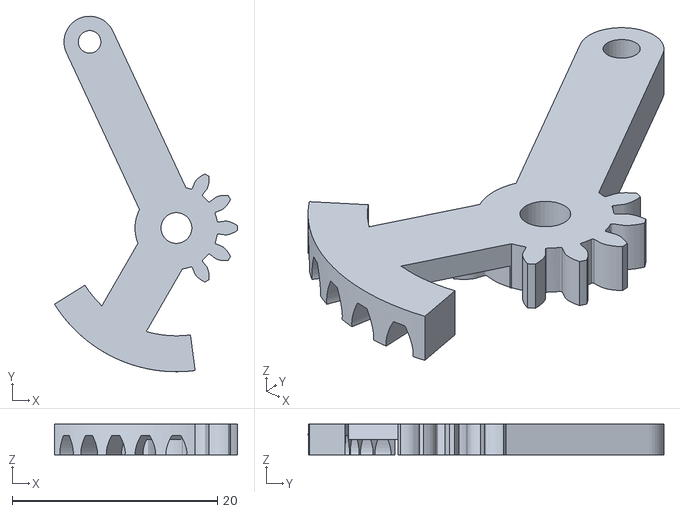
[picture p56: CAD file, 2025-07-15]
Hardware_Design/Files_for_3D_Printing/Gripper Left Gear Arm.stl
17.8 x 34.6 x 3.00
