Jvinuelapz/5DoF_Robotic_Arm/Hardware_Design/Files_for_3D_Printing/Dispenser Slider.stl

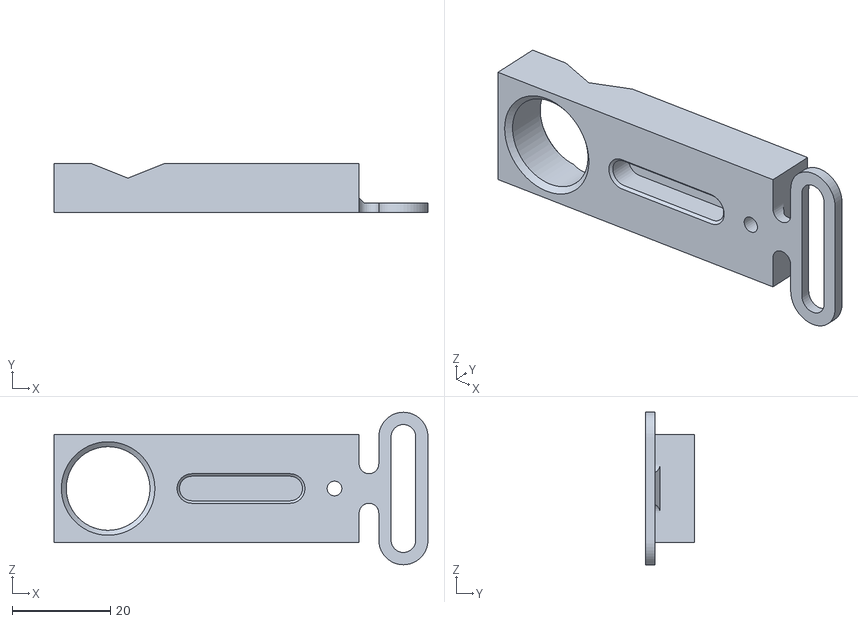
[picture p57: CAD file, 2025-07-15]
Hardware_Design/Files_for_3D_Printing/Dispenser Slider.stl
76.0 x 10.0 x 31.0
