Jvinuelapz/5DoF_Robotic_Arm/Hardware_Design/Files_for_3D_Printing/Bearing Swing.stl

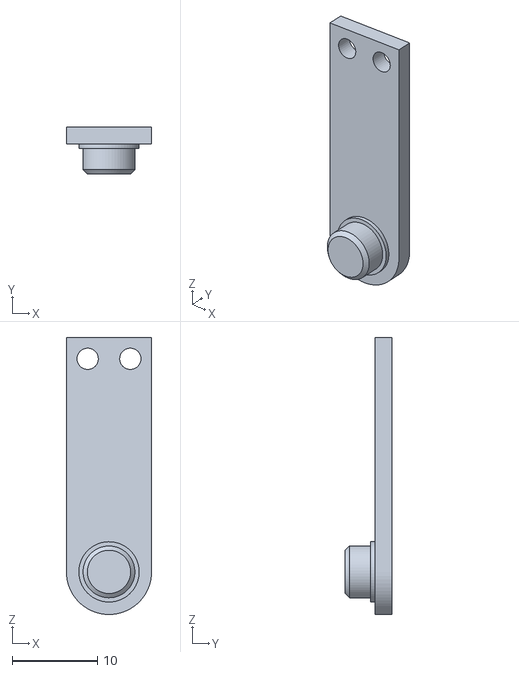
[picture p58: CAD file, 2025-07-15]
Hardware_Design/Files_for_3D_Printing/Bearing Swing.stl
10.0 x 5.50 x 32.5
