Jvinuelapz/5DoF_Robotic_Arm/Hardware_Design/Files_for_3D_Printing/Sensor Stand.stl

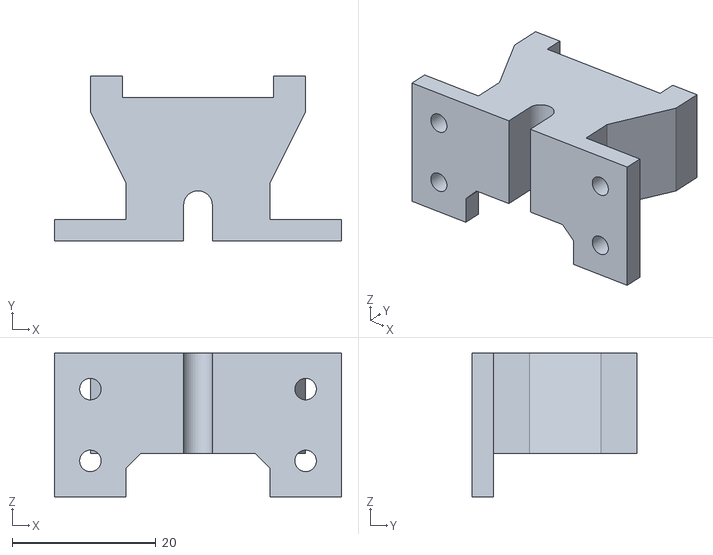
[picture p59: CAD file, 2025-07-15]
Hardware_Design/Files_for_3D_Printing/Sensor Stand.stl
40.0 x 23.0 x 20.0
