Jvinuelapz/5DoF_Robotic_Arm/Hardware_Design/Files_for_3D_Printing/SensorPlate.stl

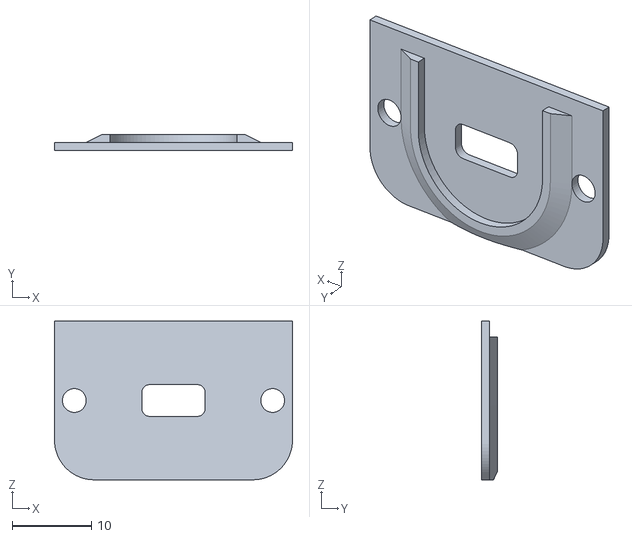
[picture p60: CAD file, 2025-07-15]
Hardware_Design/Files_for_3D_Printing/SensorPlate.stl
30.0 x 2.00 x 20.0
