Jvinuelapz/5DoF_Robotic_Arm/Hardware_Design/Files_for_3D_Printing/PCB_Box.stl

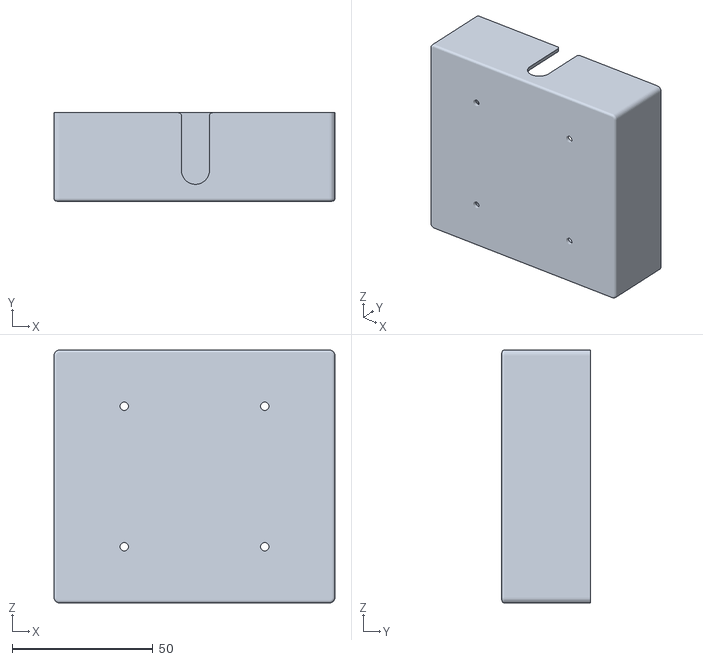
[picture p61: CAD file, 2025-07-15]
Hardware_Design/Files_for_3D_Printing/PCB_Box.stl
100.0 x 31.5 x 90.0
