Jvinuelapz/5DoF_Robotic_Arm/Hardware_Design/Files_for_3D_Printing/Shoot.stl

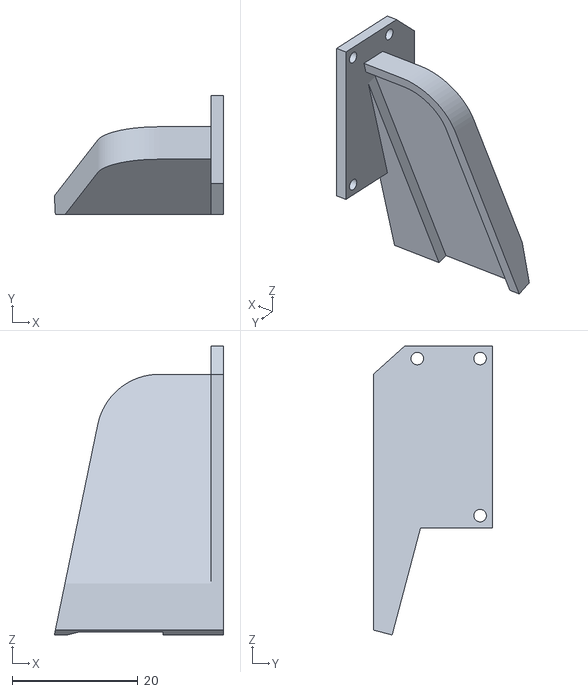
[picture p62: CAD file, 2025-07-15]
Hardware_Design/Files_for_3D_Printing/Shoot.stl
27.0 x 19.0 x 46.0
