Jvinuelapz/5DoF_Robotic_Arm/(list of files, cad)

Other CAD files:
Hardware_Design/Files_for_3D_Printing/Gripper Right Link.stl
Hardware_Design/Files_for_3D_Printing/Gripper Right Clamp.stl
Hardware_Design/CAD_Files/PCB Box v1.f3d
Hardware_Design/CAD_Files/Robot base.f3d
Hardware_Design/CAD_Files/Skittle boxes.f3d
Hardware_Design/CAD_Files/Skittle dispenser and sensor.f3d
